CGainsWorks/emb-multirail-smps/docs/spec.md

# Specification

<!-- Generated by smps.report. Do not edit by hand; `make demo` overwrites this file. -->

Generated from `simulation/smps/spec.py`, which is the only place any of these
numbers are written down.

## System

| item | value |
|---|---|
| Input voltage | 8 V to 36 V DC, nominal 24 V |
| Survivable input excursion | 40 V, non operating, clamping is external |
| Ambient | 0 C to 55 C |
| Cooling | natural convection, no heatsink |
| Useful output power | 21.45 W at the connectors |
| Junction limit assumed | 125 C for every part |
| EMC reference envelope | EN 55032 Class B, conducted, 150 kHz to 30 MHz |

## Rails

| rail | topology | control | source | Vout [V] | Iout total [A] | at connector [A] | ripple [mVpp] | tol [%] | fsw [kHz] |
|---|---|---|---|---|---|---|---|---|---|
| +5V | buck | peak-current-mode | VIN | 5.0 | 5.0 | 1.5 | 25.0 | 1.0 | 500.0 |
| +3V3 | buck | voltage-mode | +5V | 3.3 | 3.0 | 2.5 | 20.0 | 1.0 | 1000.0 |
| +12V | boost | peak-current-mode | +5V | 12.0 | 0.4 | 0.4 | 50.0 | 2.0 | 400.0 |
| +1V8A | ldo | linear | +3V3 | 1.8 | 0.5 | 0.5 | 2.0 | 2.0 | - |

The current in "Iout total" includes downstream rails. The +5V stage feeds the
+3V3 buck and the +12V boost as well as its own connector load, and the +3V3
buck feeds the +1V8A LDO, so only the "at connector" column is available to a
user. `smps.losses.solve_power_tree` works this out rather than trusting a
hand written budget.

## Transient and loop targets

| rail | load step [A] | slew [A/us] | max deviation [mV] | settle within [us] | fc target [kHz] | PM target [deg] | GM target [dB] |
|---|---|---|---|---|---|---|---|
| +5V | 1.5 | 1.0 | 150.0 | 100.0 | 50.0 | 55.0 | 8.0 |
| +3V3 | 1.0 | 1.0 | 100.0 | 50.0 | 100.0 | 55.0 | 8.0 |
| +12V | 0.2 | 0.1 | 300.0 | 1000.0 | 6.0 | 50.0 | 8.0 |
| +1V8A | 0.25 | 1.0 | 50.0 | 20.0 | 120.0 | 45.0 | 10.0 |

The +1V8A rail has a crossover target listed for completeness but it is not a
design input: the LDO's loop is inside a bought in part. What this design
controls there is the output capacitor, the preload and the input decoupling,
so the requirement on that rail is phase margin and supply rejection, not
bandwidth.

## Out of scope

* Input transient suppression beyond the 40 V survivable level.
  Load dump clamping, if the end application needs it, is an external TVS.
* Reverse polarity beyond the series diode shown in the netlist.
* Isolation. Every rail shares one return.
* Common mode emissions. The pre-scan in this repository is differential mode
  only; see `docs/emc_prescan_method.md`.
* Any form of digital telemetry or sequencing control.

## Sequencing

The rails come up in power tree order because each one is fed by the one above
it. Nothing enforces a sequence beyond that, which is adequate for the loads
described and is called out here so that a user who needs a strict sequence
knows it is not provided.
