CGainsWorks/emb-multirail-smps/docs/compensation/buck3v3_voltage_mode.md

# +3V3 buck: voltage mode, Type III compensation

Target: crossover 100 kHz, phase margin at least 55 degrees, gain margin at
least 8 dB, from a regulated 5 V input.

This rail is deliberately compensated differently from the other two. It is fed
from the +5V rail rather than from VIN, so the one percent input band removes
the main argument for current mode, and at 1 MHz a current sense chain costs a
shunt, an amplifier and a leading edge blanking window that a sawtooth and a
comparator do not. What it costs instead is six passives rather than three, and
an LC double pole to get the phase back over.

---

## 1. The plant

```
L        = 1.5 uH             DCR     = 15 mOhm
Cout     = 33 uF              ESR     = 1.0 mOhm  (two 22 uF 16 V, derated 0.75)
Rds(on)  = 30 mOhm high side, 20 mOhm low side
fsw      = 1 MHz
Vin      = 5.0 V              Vramp   = 1.0 Vpp
```

A voltage mode buck's control to output response is the modulator gain times
the LC filter:

```
Gvd(s) = (Vin / Vramp) * (1 + s/w_esr) / (1 + s/(w0 Q) + (s/w0)^2)
```

with

```
Vin/Vramp = 5.0                                            (14.0 dB)
f0        = 1 / (2 pi sqrt(1.5e-6 * 33e-6))   = 22.6 kHz
Q         = R sqrt(C/L) = 1.1 * sqrt(22)      = 5.16       at full load
f_esr     = 1 / (2 pi * 1e-3 * 33e-6)         = 4.8 MHz    (irrelevant)
```

The numeric model, which includes the DCR and the switch resistances, puts the
magnitude peak at 22.2 kHz rather than 22.6 kHz, and damps it somewhat. That is
the whole difference between the closed form above and what
`statespace.buck_model` produces.

The problem to solve is the 180 degrees the double pole takes out inside about
one octave. At 100 kHz the plant has already given up essentially all of it,
so the compensator has to hand back roughly 50 degrees to reach a 55 degree
margin. One zero cannot do that. Two can.

---

## 2. The network

Type III around a voltage feedback error amplifier:

```
Zf = (Rf + 1/sCf1) || 1/sCf2            from COMP back to FB
Zi = R1 || (R3 + 1/sCf3)                from Vout to FB
Gc(s) = Zf / Zi
```

`R1` is the top divider resistor, so the divider is inside the network and does
not appear separately in the loop gain. The bottom resistor sits on a virtual
earth and does not appear in the small signal transfer at all, which is worth
knowing when reading the loop gain plot and wondering where it went.

Zeros, poles and the values that produce them:

```
fz1 = 1 / (2 pi Rf Cf1)
fz2 = 1 / (2 pi (R1 + R3) Cf3)
fp2 = 1 / (2 pi Rf (Cf1 Cf2 / (Cf1 + Cf2)))
fp3 = 1 / (2 pi R3 Cf3)
```

### Placement

* **Both zeros at half the LC resonance, 11.1 kHz.** Putting them together at
  `f0/2` gives close to the maximum phase boost at 100 kHz while keeping the
  loop gain shape simple. Splitting them, one below `f0` and one above, buys a
  slightly flatter magnitude and slightly less boost.
* **First pole at fsw/2, 500 kHz**, to attenuate switching ripple on the FB
  pin. With ceramic output capacitors the ESR zero is at 4.8 MHz, so there is
  nothing at a sensible frequency for this pole to cancel and its job is purely
  noise rejection.
* **Second pole at fsw, 1 MHz**, for the same reason.
* **Gain solved for** so that `|Gc(fc) Gvd(fc)| = 1` at exactly 100 kHz.

### Values

```
R1   = 10.2 kOhm      chosen, sets the divider current at about 0.25 mA
Rbot = R1 * 0.891 / (3.3 - 0.891) = 3.773 kOhm -> 3.74 kOhm (E96)
Vout = 0.891 * (10.2 + 3.74) / 3.74 = 3.3210 V   (+0.64 % from nominal)

R3   = R1 / (fp3/fz2 - 1) = 10.2k / 89 = 115 Ohm (E96)
Cf3  = 1 / (2 pi * 11.1e3 * (10.2k + 115)) = 1.39 nF -> 1.3 nF (E24)
Rf   = 4.42 kOhm (E96), solved for the crossover
Cf1  = 1 / (2 pi * 11.1e3 * 4.42e3) = 3.24 nF -> 3.3 nF (E24)
Cf2  = Cf1 / (2 pi fp2 Rf Cf1 - 1)  = 76 pF   -> 75 pF (E24)
```

With those snapped values the network actually sits at

```
fz1 = 10.91 kHz     fz2 = 11.87 kHz
fp2 = 491 kHz       fp3 = 1.065 MHz
```

The 0.891 V reference is the TPS54317's. Before a regulator was chosen this
rail assumed 0.8 V, which gave 3.24 kOhm and 4.53 kOhm. With an op amp error
amplifier the bottom resistor sits on a virtual earth, so changing it moves
the set point and nothing else; `Rf` moved because the amplifier itself
changed (below).

---

## 3. Predicted margins

Contributions at 100 kHz:

| term | phase at 100 kHz |
|---|---|
| compensator integrator | -90.0 deg |
| zero at 10.91 kHz | +83.8 deg |
| zero at 11.87 kHz | +83.2 deg |
| pole at 491 kHz | -11.5 deg |
| pole at 1.065 MHz | -5.4 deg |
| plant LC double pole, 22.2 kHz, Q ~ 5 | -177.4 deg |
| plant ESR zero, 4.8 MHz | +1.2 deg |
| **total** | **-116.1 deg** |

Phase margin 63.9 degrees by hand, with an ideal amplifier, against the
numeric model's **63.3 degrees at 100.2 kHz**. The switching simulation gives
**65.9 degrees at 99.1 kHz**.

Two corrections pull in opposite directions. The closed form treats the LC
pair as undamped apart from the load, so at 100 kHz it has already surrendered
177.4 of its 180 degrees; the numeric model carries the inductor DCR and both
switch resistances, which damp the resonance and give back about 2.8 degrees.
The numeric model also carries the error amplifier's finite gain bandwidth,
which the hand sum leaves out, and that costs 3.4 degrees. Net, the numeric
model sits 0.6 degrees below the hand sum, and it is the one the compensator is
designed against.

The amplifier figures are the TPS54317 data sheet's typical values, 110 dB of
open loop gain and 5 MHz unity gain bandwidth. An earlier assumption of 12 MHz
cost only 1.4 degrees. The switching simulator carries the same finite
amplifier as the hand model; when it carried an ideal one, the 5 MHz part
opened a 6 degree gap between the two that was the simulator's omission, not
the design's.

Gain margin from the model is 11.7 dB, with the -180 degree crossing at
326 kHz. The switching measurement sees that crossing too, at 12.8 dB, because
it now falls inside the 500 kHz Nyquist limit that sampling once per switching
cycle imposes. A bench analyser triggered off the switching clock has the same
limit for the same reason.

---

## 4. Across the operating range

| operating point | fc | PM | GM |
|---|---|---|---|
| 5.00 V, 3.0 A | 100.2 kHz | 63.3 deg | 11.7 dB |
| 4.95 V, 3.0 A | 99.3 kHz | 63.4 deg | 11.8 dB |
| 5.05 V, 3.0 A | 101.2 kHz | 63.2 deg | 11.6 dB |
| 5.00 V, 0.3 A | 100.9 kHz | 60.8 deg | 11.5 dB |

A one percent input band moves the crossover by one percent, which is what a
voltage mode modulator with gain `Vin/Vramp` should do and is the reason this
scheme is only acceptable on a rail with a regulated input. Put the same loop
on 8 to 36 V and the crossover would move by a factor of 4.5.

Light load raises the LC Q, which is why the phase margin is worst at 0.3 A
rather than at full load. It is still 5.8 degrees above target.

---

## 5. What would change this

1. **The power stage resistance.** The TPS54317's ramp, 1.0 Vpp, is now a
   data sheet figure and matches what this design assumed. Its FETs are not:
   59 mOhm typical at 6 V against the 30 and 20 mOhm modelled. More
   resistance damps the LC pair, which helps the margin a little and costs
   efficiency, and it is on `outputs/VERIFY.csv` to be re-run.
2. **Ceramic derating at 3.3 V.** The 0.75 retention factor sets the LC
   resonance. If the real parts hold 0.6, `f0` moves to 25 kHz and both
   compensator zeros are then placed too low.
3. **Discontinuous conduction below about 0.4 A.** Below that the inductor
   current touches zero, the plant becomes first order and this compensator is
   over compensated rather than under, which is the safe direction but is not
   modelled here.
