CGainsWorks/emb-multirail-smps/test-results/emc-prescan/spectrum.csv

f_hz | level_dbuv | limit_dbuv | margin_db | v_in_v
500000.0 | 51.28 | 56.0 | 4.72 | 8.0
1000000.0 | 20.46 | 56.0 | 35.54 | 8.0
1500000.0 | -23.24 | 56.0 | 79.24 | 8.0
2000000.0 | -15.28 | 56.0 | 71.28 | 8.0
2500000.0 | -12.65 | 56.0 | 68.65 | 8.0
3000000.0 | -10.25 | 56.0 | 66.25 | 8.0
3500000.0 | -3.62 | 56.0 | 59.62 | 8.0
4000000.0 | -13.44 | 56.0 | 69.44 | 8.0
4500000.0 | -6.15 | 56.0 | 62.15 | 8.0
5000000.0 | -4.41 | 60.0 | 64.41 | 8.0
5500000.0 | -31.35 | 60.0 | 91.35 | 8.0
6000000.0 | -5.56 | 60.0 | 65.56 | 8.0
6500000.0 | -7.05 | 60.0 | 67.05 | 8.0
7000000.0 | -18.27 | 60.0 | 78.27 | 8.0
7500000.0 | -6.06 | 60.0 | 66.06 | 8.0
8000000.0 | -10.87 | 60.0 | 70.87 | 8.0
8500000.0 | -13.08 | 60.0 | 73.08 | 8.0
9000000.0 | -7.2 | 60.0 | 67.2 | 8.0
9500000.0 | -16.64 | 60.0 | 76.64 | 8.0
10000000.0 | -11.07 | 60.0 | 71.07 | 8.0
10500000.0 | -8.91 | 60.0 | 68.91 | 8.0
11000000.0 | -29.97 | 60.0 | 89.97 | 8.0
11500000.0 | -10.35 | 60.0 | 70.35 | 8.0
12000000.0 | -11.26 | 60.0 | 71.26 | 8.0
12500000.0 | -24.45 | 60.0 | 84.45 | 8.0
13000000.0 | -10.43 | 60.0 | 70.43 | 8.0
13500000.0 | -14.54 | 60.0 | 74.54 | 8.0
14000000.0 | -17.86 | 60.0 | 77.86 | 8.0
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
