CGainsWorks/emb-multirail-smps/test-results/transient/load_step.csv

rail | step_a | undershoot_mv | overshoot_mv | limit_mv | settle_time_us | settle_limit_us
+5V | 1.5 | 98.72 | 2.53 | 150.0 | 28.4 | 100.0
+3V3 | 1.0 | 42.78 | 2.89 | 100.0 | 5.3 | 50.0
+12V | 0.2 | 197.82 | 12.21 | 300.0 | 241.5 | 1000.0
