CGainsWorks/emb-multirail-smps/test-results/transient/3v3_load_step.png

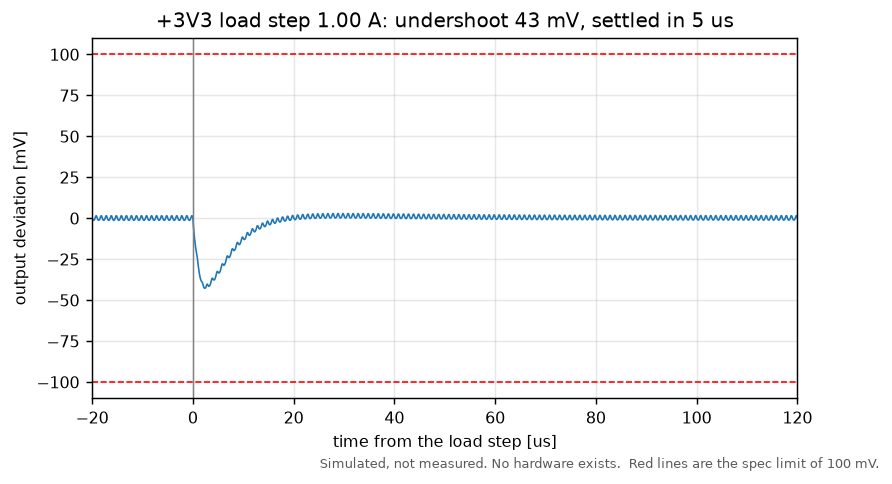
test-results/transient/3v3_load_step.png
