CGainsWorks/emb-multirail-smps/test-results/transient/12v_load_step.png

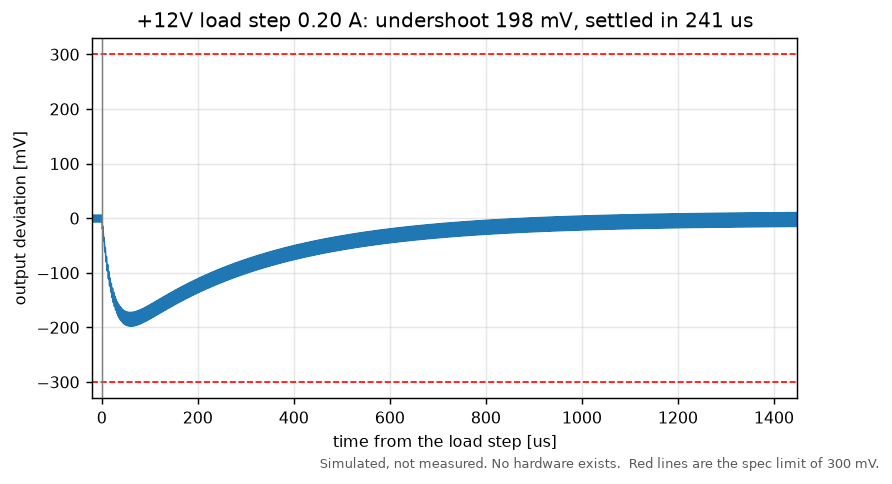
test-results/transient/12v_load_step.png
