CGainsWorks/emb-multirail-smps/docs/validation_report.md

# Validation report

<!-- Generated by smps.report. Do not edit by hand; `make demo` overwrites this file. -->

Every number in this file is produced by `make demo`. The date it was produced
is in the git history, which is a better record than a line in a generated
document that would otherwise change every day for no reason.

## What was validated, and what that word means here

Nothing in this report is a measurement. No board has been fabricated,
assembled, powered or probed. Every figure comes from a model running on a
desktop machine.

What has been checked is the thing the project brief puts first: that the loop
compensation derived by hand produces the crossover and phase margin claimed
for it, when the actual switching converter is simulated cycle by cycle with a
small signal injected into the feedback path and the loop gain extracted the
same way a Bode analyser extracts it.

Two independent routes to the same number:

1. **Hand derived.** Each power stage is written as two linear systems, one per
   switch state, averaged and linearised. For the current mode rails the
   comparator loop is closed with the Ridley sampled data model. The
   compensator is a closed form network response. `docs/compensation/` shows
   the derivation with this board's arithmetic written out.
2. **Simulated.** The same converter run as a switching circuit, with the
   compensator carried as extra states, the switching instant found by root
   finding on the real comparator condition, and the loop gain measured by
   injection.

They share the component values and nothing else. The power stage model in
route 2 does not use route 1's transfer functions.

## Result: the two routes agree

| rail | f_cross_target_hz | f_cross_hand_hz | f_cross_sim_hz | f_cross_error_pct | pm_target_deg | pm_hand_deg | pm_sim_deg | pm_error_deg | gm_hand_db | gm_sim_db | injection_linearity_rel |
|---|---|---|---|---|---|---|---|---|---|---|---|
| +5V | 50000.0 | 50544.3 | 50773.5 | 0.45 | 55.0 | 60.92 | 62.81 | 1.88 | 12.49 | no -180 deg crossing below fsw/2 | 1.22e-04 |
| +3V3 | 100000.0 | 100229.1 | 99052.6 | -1.17 | 55.0 | 63.3 | 65.89 | 2.59 | 11.7 | 12.82 | 1.62e-04 |
| +12V | 6000.0 | 5935.5 | 6262.7 | 5.51 | 50.0 | 76.6 | 78.32 | 1.72 | 14.3 | 15.5 | 1.39e-04 |

Worst crossover disagreement 5.5 percent, worst phase margin
disagreement 2.6 degrees. The gate the brief sets, that the
simulation has to match the hand calculation before boards are ordered, is met.

`injection_linearity_rel` is the fractional change in measured loop gain when
the injection amplitude is doubled. Values around 1e-4 mean the measurement is
in the small signal regime, which is the same check a careful bench sweep does.

Where the simulation is expected to differ from the hand model, and does:

* Above roughly a fifth of the switching frequency the averaged model loses
  accuracy because averaging assumes the ripple is small compared with the
  signal being measured. That is visible as the two traces separating at the
  top of each Bode plot.
* The boost disagrees slightly more than the bucks at low frequency. The
  Ridley model drops the input and output voltage feedforward terms in the
  duty cycle modulator, and for a boost those are not quite negligible.
* Neither route models dead time, reverse recovery, gate driver delay or
  layout inductance. All of those cost phase on real hardware, so a bench
  measurement should come in worse than this, not better.

## Sizing against the specification

| quantity | unit | required | chosen | direction | margin_pct | pass | note |
|---|---|---|---|---|---|---|---|
| L, +5V buck | H | 5.74074e-06 | 6.8e-06 | chosen >= required | 18.45 | True | 30% ripple at Vin(max) = 36 V |
| Inductor Isat headroom, +5V | A | 5.63317 | 9 | chosen >= required | 59.77 | True | peak = Iout + dI/2 = 5.633 A |
| Cout, +5V buck | F | 2.11057e-05 | 4.62e-05 | chosen >= required | 118.9 | True | capacitive share of the ripple budget |
| Output ripple, +5V | Vpp | 0.025 | 0.00769672 | chosen <= required | 69.21 | True | capacitive plus ESR, steady state |
| Load step deviation, +5V | V | 0.15 | 0.103347 | chosen <= required | 31.1 | True | dI/(2*pi*fc*Cout) at fc = 50 kHz |
| L, +3V3 buck | H | 1.24667e-06 | 1.5e-06 | chosen >= required | 20.32 | True | 30% ripple, fixed 5 V input |
| Inductor Isat headroom, +3V3 | A | 3.374 | 6 | chosen >= required | 77.83 | True | peak = 3.374 A |
| Cout, +3V3 buck | F | 7.79167e-06 | 3.3e-05 | chosen >= required | 323.53 | True |  |
| Output ripple, +3V3 | Vpp | 0.02 | 0.00358133 | chosen <= required | 82.09 | True |  |
| Load step deviation, +3V3 | V | 0.1 | 0.0482288 | chosen <= required | 51.77 | True |  |
| fc / f_LC ratio, +3V3 | - | 3 | 4.42061 | chosen >= required | 47.35 | True | f_LC = 22.62 kHz, needs enough separation for Type III |
| L, +12V boost | H | 2.17014e-05 | 2.2e-05 | chosen >= required | 1.38 | True | 35% of IL = 0.960 A, raised from 30 % to keep the RHP zero high |
| Inductor Isat headroom, +12V | A | 1.12572 | 2.5 | chosen >= required | 122.08 | True | peak = 1.126 A |
| Cout, +12V boost | F | 1.94444e-05 | 2.42e-05 | chosen >= required | 24.46 | True |  |
| Output ripple, +12V | Vpp | 0.05 | 0.0257933 | chosen <= required | 48.41 | True |  |
| f_RHPZ / fc ratio, +12V | - | 5 | 6.27979 | chosen >= required | 25.6 | True | f_RHPZ = 37.68 kHz at full load |
| Load step deviation, +12V | V | 0.3 | 0.219222 | chosen <= required | 26.93 | True |  |
| Dropout headroom, +1V8A | V | 0.25 | 1.2987 | chosen >= required | 419.48 | True | worst case 3V3 low, less 168 mV across the input filter resistor |
| LDO dissipation, +1V8A | W | 1 | 0.75 | chosen <= required | 25.0 | True | package limit assumption, confirm with the real thermal pad |

## Load regulation and ripple

| rail | v_in_v | i_out_a | v_out_v | deviation_from_light_load_pct | ripple_mvpp | ripple_limit_mvpp |
|---|---|---|---|---|---|---|
| +5V | 24.0 | 0.25 | 4.984357 | 0.0 | 6.32 | 25.0 |
| +5V | 24.0 | 1.25 | 4.984343 | -0.0 | 6.339 | 25.0 |
| +5V | 24.0 | 2.5 | 4.984333 | -0.0 | 6.363 | 25.0 |
| +5V | 24.0 | 3.75 | 4.984323 | -0.001 | 6.386 | 25.0 |
| +5V | 24.0 | 5.0 | 4.98432 | -0.001 | 6.41 | 25.0 |
| +3V3 | 5.0 | 0.15 | 3.321 | 0.0 | 2.863 | 20.0 |
| +3V3 | 5.0 | 0.75 | 3.321 | -0.0 | 2.838 | 20.0 |
| +3V3 | 5.0 | 1.5 | 3.321 | -0.0 | 2.806 | 20.0 |
| +3V3 | 5.0 | 2.25 | 3.321001 | 0.0 | 2.773 | 20.0 |
| +3V3 | 5.0 | 3.0 | 3.321 | 0.0 | 2.739 | 20.0 |
| +12V | 5.0 | 0.02 | 12.026313 | 0.0 | 2.474 | 50.0 |
| +12V | 5.0 | 0.1 | 12.026274 | -0.0 | 6.26 | 50.0 |
| +12V | 5.0 | 0.2 | 12.026225 | -0.001 | 12.649 | 50.0 |
| +12V | 5.0 | 0.3 | 12.026177 | -0.001 | 19.157 | 50.0 |
| +12V | 5.0 | 0.4 | 12.026195 | -0.001 | 25.704 | 50.0 |

## Line regulation

| rail | v_in_v | i_out_a | v_out_v | deviation_from_8v_pct | ripple_mvpp |
|---|---|---|---|---|---|
| +5V | 8.0 | 5.0 | 4.984322 | 0.0 | 2.949 |
| +5V | 12.0 | 5.0 | 4.98432 | -0.0 | 4.669 |
| +5V | 18.0 | 5.0 | 4.984316 | -0.0 | 5.828 |
| +5V | 24.0 | 5.0 | 4.98432 | -0.0 | 6.41 |
| +5V | 30.0 | 5.0 | 4.984312 | -0.0 | 6.759 |
| +5V | 36.0 | 5.0 | 4.98431 | -0.0 | 7.001 |
| +3V3 | 4.95 | 3.0 | 3.321 | 0.0 | 2.678 |
| +3V3 | 5.0 | 3.0 | 3.321 | 0.0 | 2.739 |
| +3V3 | 5.05 | 3.0 | 3.321 | 0.0 | 2.798 |
| +12V | 4.95 | 0.4 | 12.026124 | 0.0 | 25.895 |
| +12V | 5.0 | 0.4 | 12.026195 | 0.001 | 25.704 |
| +12V | 5.05 | 0.4 | 12.02613 | 0.0 | 25.513 |

The +5V stage is essentially indifferent to input voltage, which is not an
accident and is worth stating precisely because it looks too good. With peak
current mode and the artificial ramp set to the falling inductor current slope,
the modulator gain goes as 1/Vin while the control to output gain goes as Vin,
and the two cancel exactly in the averaged model. The real converter will not
be perfectly flat, because dead time, gate drive timing and Rds(on) all move
with operating point and none of them are in this model.

## Load transient

| rail | step_a | undershoot_mv | overshoot_mv | limit_mv | settle_time_us | settle_limit_us |
|---|---|---|---|---|---|---|
| +5V | 1.5 | 98.72 | 2.53 | 150.0 | 28.4 | 100.0 |
| +3V3 | 1.0 | 42.78 | 2.89 | 100.0 | 5.3 | 50.0 |
| +12V | 0.2 | 197.82 | 12.21 | 300.0 | 241.5 | 1000.0 |

## Efficiency

| v_in_v | load_fraction | p_in_w | i_in_a | p_useful_w | p_loss_w | efficiency_pct |
|---|---|---|---|---|---|---|
| 8.0 | 0.1 | 2.5217 | 0.3152 | 2.145 | 0.3767 | 85.063 |
| 8.0 | 0.25 | 5.9769 | 0.7471 | 5.3625 | 0.6144 | 89.72 |
| 8.0 | 0.5 | 11.8288 | 1.4786 | 10.725 | 1.1038 | 90.668 |
| 8.0 | 0.75 | 17.7991 | 2.2249 | 16.0875 | 1.7116 | 90.384 |
| 8.0 | 1.0 | 23.8899 | 2.9862 | 21.45 | 2.4399 | 89.787 |
| 24.0 | 0.1 | 2.6399 | 0.11 | 2.145 | 0.4949 | 81.253 |
| 24.0 | 0.25 | 6.16 | 0.2567 | 5.3625 | 0.7975 | 87.054 |
| 24.0 | 0.5 | 12.1206 | 0.505 | 10.725 | 1.3956 | 88.486 |
| 24.0 | 0.75 | 18.2004 | 0.7583 | 16.0875 | 2.1129 | 88.391 |
| 24.0 | 1.0 | 24.4017 | 1.0167 | 21.45 | 2.9517 | 87.904 |
| 36.0 | 0.1 | 2.7241 | 0.0757 | 2.145 | 0.5791 | 78.742 |
| 36.0 | 0.25 | 6.2928 | 0.1748 | 5.3625 | 0.9303 | 85.217 |
| 36.0 | 0.5 | 12.3349 | 0.3426 | 10.725 | 1.6099 | 86.948 |
| 36.0 | 0.75 | 18.497 | 0.5138 | 16.0875 | 2.4095 | 86.974 |
| 36.0 | 1.0 | 24.7811 | 0.6884 | 21.45 | 3.3311 | 86.558 |

Per stage numbers are in `test-results/efficiency/stage_efficiency.csv`. The
+1V8A rail sits near 1.8/3.3 by construction: it is a linear regulator and the
difference is heat, which is the price paid for a quiet analogue supply.

At high line the +5V stage is dominated by switching loss, not conduction loss.
If a bench measurement ever disagrees with this model, that is the term to
suspect first, because the overlap time it depends on is the hardest quantity
to predict from a datasheet.

## Thermal

Board to ambient resistance used: 7.44 K/W, from
100 by 80 mm of board, both faces,
natural convection plus radiation, derated to 60% for
the fraction actually coupled to the power stages.

| device | power_w | rth_jb_k_per_w | t_board_c | t_junction_c | margin_to_125c_k | v_in_v | t_ambient_c |
|---|---|---|---|---|---|---|---|
| U5 1V8 LDO | 0.6793 | 20.0 | 73.15 | 86.74 | 38.26 | 8.0 | 55.0 |
| U3 3V3 regulator | 0.4249 | 18.0 | 73.15 | 80.8 | 44.2 | 8.0 | 55.0 |
| L1 buck inductor | 0.2334 | 25.0 | 73.15 | 78.99 | 46.01 | 8.0 | 55.0 |
| Q1 buck HS FET | 0.4453 | 12.0 | 73.15 | 78.5 | 46.5 | 8.0 | 55.0 |
| Rs1 sense resistor | 0.1053 | 40.0 | 73.15 | 77.37 | 47.63 | 8.0 | 55.0 |
| L2 3V3 inductor | 0.1383 | 30.0 | 73.15 | 77.3 | 47.7 | 8.0 | 55.0 |
| Q3/Q4 boost FETs | 0.1011 | 35.0 | 73.15 | 76.69 | 48.31 | 8.0 | 55.0 |
| Q2 buck LS FET | 0.2461 | 12.0 | 73.15 | 76.11 | 48.89 | 8.0 | 55.0 |
| L3 boost inductor | 0.045 | 30.0 | 73.15 | 74.5 | 50.5 | 8.0 | 55.0 |
| U5 1V8 LDO | 0.6793 | 20.0 | 76.96 | 90.55 | 34.45 | 24.0 | 55.0 |
| Q1 buck HS FET | 0.8515 | 12.0 | 76.96 | 87.18 | 37.82 | 24.0 | 55.0 |
| U3 3V3 regulator | 0.4249 | 18.0 | 76.96 | 84.61 | 40.39 | 24.0 | 55.0 |
| L1 buck inductor | 0.2415 | 25.0 | 76.96 | 83.0 | 42.0 | 24.0 | 55.0 |
| Rs1 sense resistor | 0.1053 | 40.0 | 76.96 | 81.18 | 43.82 | 24.0 | 55.0 |
| L2 3V3 inductor | 0.1383 | 30.0 | 76.96 | 81.11 | 43.89 | 24.0 | 55.0 |
| Q2 buck LS FET | 0.3455 | 12.0 | 76.96 | 81.11 | 43.89 | 24.0 | 55.0 |
| Q3/Q4 boost FETs | 0.1011 | 35.0 | 76.96 | 80.5 | 44.5 | 24.0 | 55.0 |
| L3 boost inductor | 0.045 | 30.0 | 76.96 | 78.31 | 46.69 | 24.0 | 55.0 |
| Q1 buck HS FET | 1.2135 | 12.0 | 79.79 | 94.35 | 30.65 | 36.0 | 55.0 |
| U5 1V8 LDO | 0.6793 | 20.0 | 79.79 | 93.37 | 31.63 | 36.0 | 55.0 |
| U3 3V3 regulator | 0.4249 | 18.0 | 79.79 | 87.43 | 37.57 | 36.0 | 55.0 |
| L1 buck inductor | 0.2437 | 25.0 | 79.79 | 85.88 | 39.12 | 36.0 | 55.0 |
| Q2 buck LS FET | 0.3622 | 12.0 | 79.79 | 84.13 | 40.87 | 36.0 | 55.0 |
| Rs1 sense resistor | 0.1053 | 40.0 | 79.79 | 84.0 | 41.0 | 36.0 | 55.0 |
| L2 3V3 inductor | 0.1383 | 30.0 | 79.79 | 83.94 | 41.06 | 36.0 | 55.0 |
| Q3/Q4 boost FETs | 0.1011 | 35.0 | 79.79 | 83.32 | 41.68 | 36.0 | 55.0 |
| L3 boost inductor | 0.045 | 30.0 | 79.79 | 81.13 | 43.87 | 36.0 | 55.0 |

Maximum ambient at full load across the input range:
85.7 C against a specification of
55 C.

This is the crudest model here. It treats the board as isothermal, which it
will not be. Expect the real hot spot under the high side FET to be worse than
this says and the parts far from it to be better.

## Conducted emissions pre-scan

| v_in_v | worst_margin_db | worst_frequency_hz | filter_z_out_peak_ohm | filter_z_out_peak_hz | converter_z_in_ohm | middlebrook_separation_db |
|---|---|---|---|---|---|---|
| 8.0 | 4.72 | 500000.0 | 0.5006 | 3147.7 | 2.679 | 14.57 |
| 24.0 | 8.05 | 500000.0 | 0.5006 | 3147.7 | 23.605 | 33.47 |
| 36.0 | 11.2 | 500000.0 | 0.5006 | 3147.7 | 52.298 | 40.38 |

Differential mode only, modelled through a 10 uH input
inductor into a 2.2 uF film capacitor and a 50 ohm / 5 uH LISN.
The worst case is the fundamental at the switching frequency at low line, with
4.7 dB of margin at
Vin 8 V. That is thin for a prediction with this
much uncertainty in it, and it is the first thing a real pre-scan should look
at.

The input filter is also checked against Middlebrook's criterion, because a
converter running closed loop is a constant power load and looks like a
negative resistance below its loop bandwidth. Worst separation between the
filter output impedance and the converter input impedance is
14.6 dB. This is why the bulk
capacitor is an aluminium polymer part with deliberate ESR: swapping it for
more ceramic would improve the ripple and destabilise the input.

## Netlist

| parts | nets | pin_connections | single_pin_nets | duplicate_pin_connections | parts_with_no_net |
|---|---|---|---|---|---|
| 79 | 52 | 233 | 0 | 0 | 0 |

`outputs/netlists/board.net` is a Protel format netlist, which Altium imports
directly. It is a connection list, not a layout.

## How reproducible is any of this

Every result here is regenerated by `make demo` and compared against what is
committed, by `scripts/check_outputs_current.py`, on every push.

That comparison is numerical rather than byte for byte, and deliberately so.
The switching simulator finds each switching instant by secant iteration on the
real comparator condition, and where that iteration stops depends on the last
bits of a double precision subtraction. The closed loop then integrates the
resulting duty ratio differences over thousands of cycles. Measured across
Windows with numpy 1.26 and Linux with numpy 2.5, the settled output voltages
agree to about **one part per million**.

That is three orders of magnitude finer than any claim this report makes, and
roughly four orders finer than the uncertainty in the component values the
numbers are computed from, so it does not affect a single conclusion. It is
worth stating because it is the honest resolution of the simulator, and because
a reader comparing two runs digit by digit should know where to stop.

The one place it does matter is the load regulation table. The deviations there
are around 0.001 percent, which is only about ten times the solver's own
resolution. Read that column as "below what this model can resolve", not as a
measurement of 0.001 percent.

## What would change these numbers

In rough order of how much:

1. Real Rds(on), Qg, Qoss and switching times, at temperature, for real parts.
2. Real inductor core loss coefficients and DCR at temperature.
3. Layout: loop inductance in the input mesh, copper spreading for thermal,
   and the common mode path for EMC. None of it exists yet.
4. The controller's actual internal slope compensation, blanking and minimum
   on time, which this repository models generically rather than from any one
   datasheet.
