CGainsWorks/emb-multirail-smps/test-results/thermal/ambient_derating.csv

v_in_v | load_fraction | max_ambient_c
8.0 | 0.1 | 120.42
8.0 | 0.2 | 117.83
8.0 | 0.3 | 115.14
8.0 | 0.4 | 112.34
8.0 | 0.5 | 109.43
8.0 | 0.6 | 106.42
8.0 | 0.7 | 103.29
8.0 | 0.8 | 100.06
8.0 | 0.9 | 96.72
8.0 | 1.0 | 93.26
24.0 | 0.1 | 118.8
24.0 | 0.2 | 116.54
24.0 | 0.3 | 113.61
24.0 | 0.4 | 110.49
24.0 | 0.5 | 107.26
24.0 | 0.6 | 103.92
24.0 | 0.7 | 100.47
24.0 | 0.8 | 96.91
24.0 | 0.9 | 93.24
24.0 | 1.0 | 89.45
36.0 | 0.1 | 117.2
36.0 | 0.2 | 114.31
36.0 | 0.3 | 111.27
36.0 | 0.4 | 108.08
36.0 | 0.5 | 104.74
36.0 | 0.6 | 101.24
36.0 | 0.7 | 97.58
36.0 | 0.8 | 93.76
36.0 | 0.9 | 89.79
36.0 | 1.0 | 85.65
