CGainsWorks/emb-multirail-smps/test-results/bode/sweep_12v.csv

f_hz | gain_db | phase_deg
200.0 | 29.6141 | -93.6048
261.31 | 27.3072 | -92.899
341.406 | 25.0011 | -92.4204
446.055 | 22.6967 | -92.1446
582.772 | 20.394 | -92.0588
761.542 | 18.0906 | -92.157
995.025 | 15.7888 | -92.4375
1299.756 | 13.4901 | -92.9057
1698.514 | 11.1894 | -93.58
2219.14 | 8.8933 | -94.4924
2898.551 | 6.603 | -95.6941
3786.982 | 4.3126 | -97.26
4945.904 | 2.025 | -99.3003
6464.646 | -0.2723 | -102.0024
8443.272 | -2.5633 | -105.6085
11034.483 | -4.8457 | -110.4723
14414.414 | -7.078 | -116.9493
18823.529 | -9.2086 | -125.3849
24615.385 | -11.1796 | -136.0841
32323.232 | -12.93 | -149.2382
42105.263 | -14.3457 | -163.9453
55172.414 | -15.5393 | 179.4261
71111.111 | -16.5322 | 162.4434
94117.647 | -17.6407 | 141.6161
125000.0 | -18.7484 | 116.5349
162500.0 | -19.7383 | 89.0571
