CGainsWorks/emb-multirail-smps/test-results/bode/sweep_3v3.csv

f_hz | gain_db | phase_deg
2000.0 | 21.3143 | -72.5704
2438.281 | 19.7716 | -68.7038
2971.768 | 18.3043 | -64.1273
3623.188 | 16.9379 | -58.7449
4417.449 | 15.7162 | -52.5181
5383.58 | 14.6967 | -45.488
6562.756 | 13.9479 | -37.771
8000.0 | 13.5626 | -29.6908
9756.098 | 13.6557 | -21.8028
11887.073 | 14.3728 | -15.1587
14492.754 | 15.9288 | -11.6618
17660.044 | 18.5779 | -16.2551
21505.376 | 21.5655 | -42.6328
26229.508 | 19.6473 | -85.8322
32000.0 | 14.9805 | -104.3572
39024.39 | 11.1779 | -109.6496
47619.048 | 8.1545 | -111.0537
57971.014 | 5.6488 | -111.4058
70796.46 | 3.4002 | -111.78
86021.505 | 1.3837 | -112.7064
105263.158 | -0.5965 | -114.7158
126984.127 | -2.3777 | -118.0157
156862.745 | -4.3542 | -124.1708
190476.19 | -6.1899 | -133.1527
228571.429 | -8.0185 | -145.5349
281250.0 | -10.5099 | -164.7498
343750.0 | -14.1705 | 171.0547
406250.0 | -18.779 | 143.308
