CGainsWorks/emb-multirail-smps/test-results/bode/sweep_5v.csv

f_hz | gain_db | phase_deg
1000.0 | 35.2721 | -91.8317
1219.141 | 33.5262 | -92.2741
1485.884 | 31.7734 | -92.7626
1811.594 | 30.0059 | -93.2929
2208.724 | 28.2248 | -93.8499
2691.79 | 26.4337 | -94.4106
3281.378 | 24.6282 | -94.9522
4000.0 | 22.8157 | -95.4561
4878.049 | 20.9989 | -95.9234
5943.536 | 19.1967 | -96.3761
7246.377 | 17.4008 | -96.8653
8830.022 | 15.6244 | -97.4494
10752.688 | 13.8683 | -98.1919
13114.754 | 12.1106 | -99.166
16000.0 | 10.3596 | -100.4296
19512.195 | 8.6167 | -102.0385
23809.524 | 6.8675 | -104.0652
28985.507 | 5.13 | -106.5449
35398.23 | 3.344 | -109.6379
43010.753 | 1.5664 | -113.324
52631.579 | -0.3393 | -118.031
63492.063 | -2.192 | -123.4853
78431.373 | -4.3797 | -131.3017
95238.095 | -6.4498 | -140.2457
114285.714 | -8.4236 | -149.8171
140625.0 | -10.7385 | -161.2987
171875.0 | -13.1566 | -171.9795
203125.0 | -15.1835 | -179.6957
