CGainsWorks/emb-multirail-smps/test-results/efficiency/curve_12v.csv

i_out_a | efficiency_pct
0.008 | 80.5722
0.00884 | 82.0282
0.00978 | 83.3907
0.01081 | 84.6623
0.01195 | 85.8457
0.01321 | 86.9444
0.0146 | 87.9618
0.01614 | 88.902
0.01785 | 89.7689
0.01973 | 90.5666
0.02181 | 91.2991
0.02411 | 91.9705
0.02666 | 92.5848
0.02947 | 93.1457
0.03258 | 93.6569
0.03602 | 94.1219
0.03982 | 94.5439
0.04402 | 94.926
0.04867 | 95.2711
0.0538 | 95.5819
0.05948 | 95.8608
0.06575 | 96.11
0.07269 | 96.3317
0.08036 | 96.5276
0.08884 | 96.6994
0.09821 | 96.8486
0.10858 | 96.9765
0.12003 | 97.084
0.1327 | 97.1723
0.1467 | 97.242
0.16218 | 97.2937
0.17929 | 97.3278
0.19821 | 97.3446
0.21912 | 97.3441
0.24224 | 97.3263
0.2678 | 97.2908
0.29605 | 97.2373
0.32729 | 97.165
0.36182 | 97.0732
0.4 | 96.9606
