CGainsWorks/emb-multirail-smps/test-results/bode/1v8a_ldo_loop_gain.png

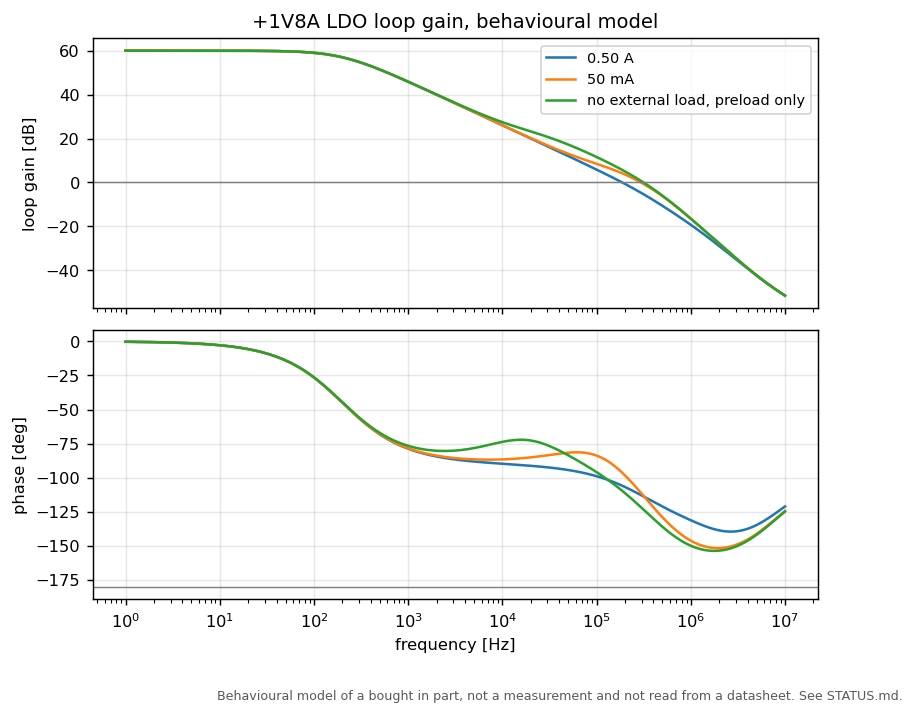
test-results/bode/1v8a_ldo_loop_gain.png
