CGainsWorks/emb-multirail-smps/test-results/bode/1v8a_ldo_psrr.png

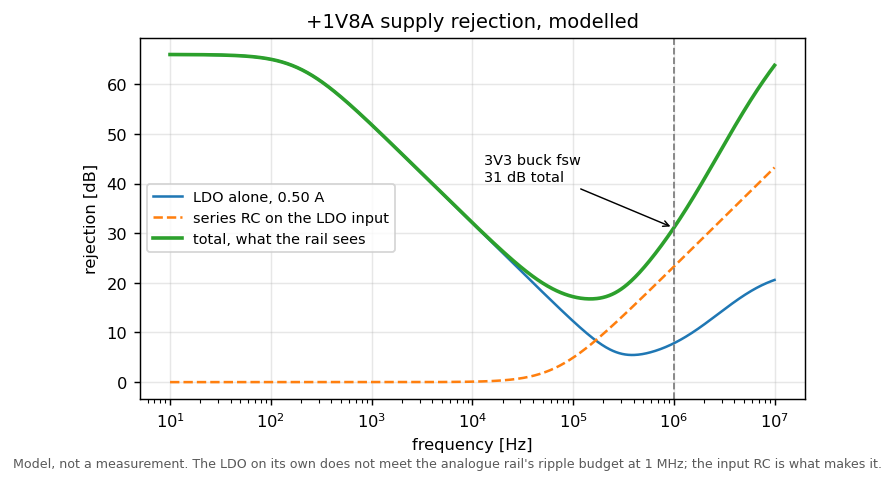
test-results/bode/1v8a_ldo_psrr.png
