CGainsWorks/emb-multirail-smps/test-results/bode/3v3_loop_gain.png

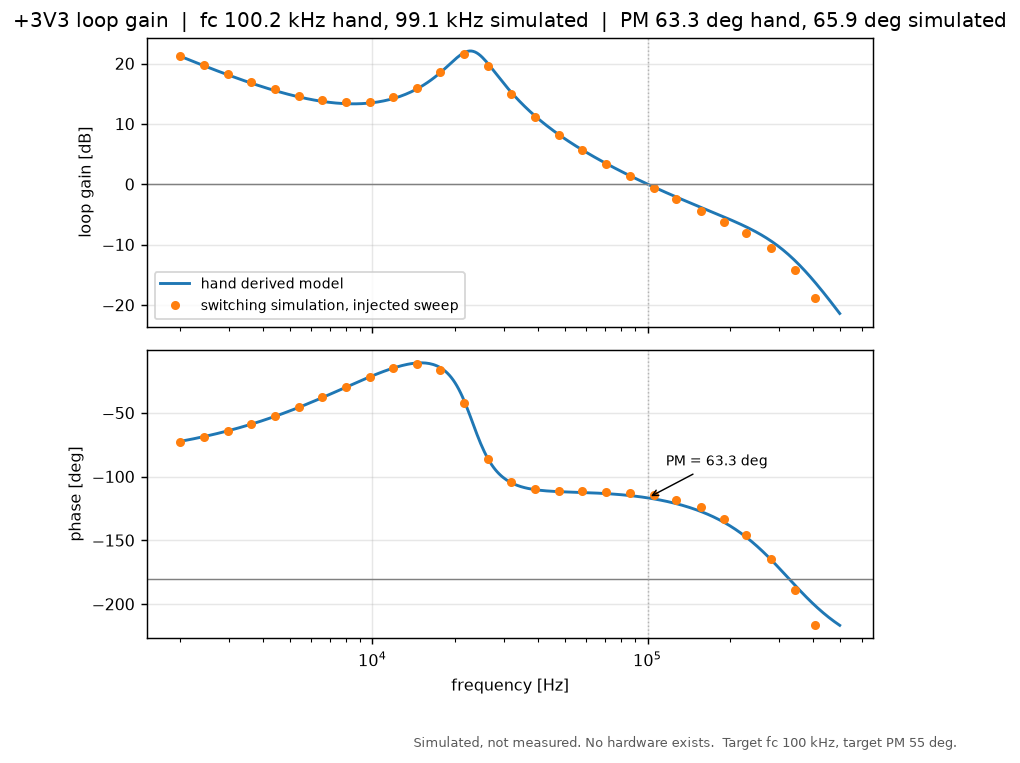
test-results/bode/3v3_loop_gain.png
