CGainsWorks/emb-multirail-smps/test-results/bode/12v_loop_gain.png

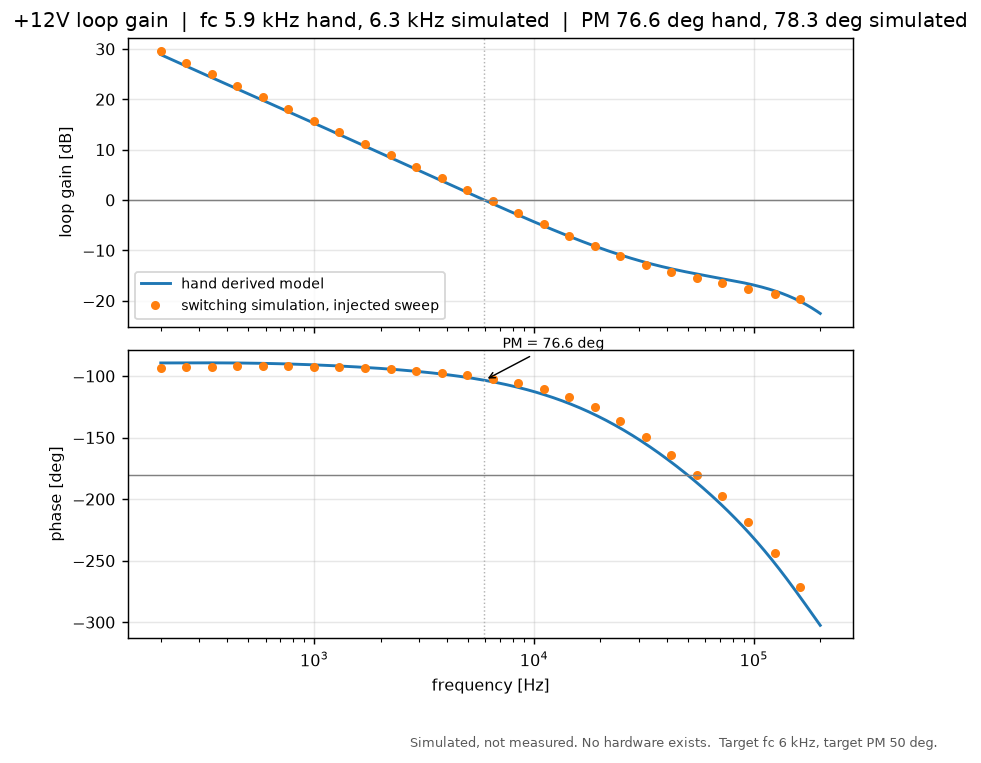
test-results/bode/12v_loop_gain.png
