CGainsWorks/emb-multirail-smps/test-results/efficiency/stage_efficiency.png

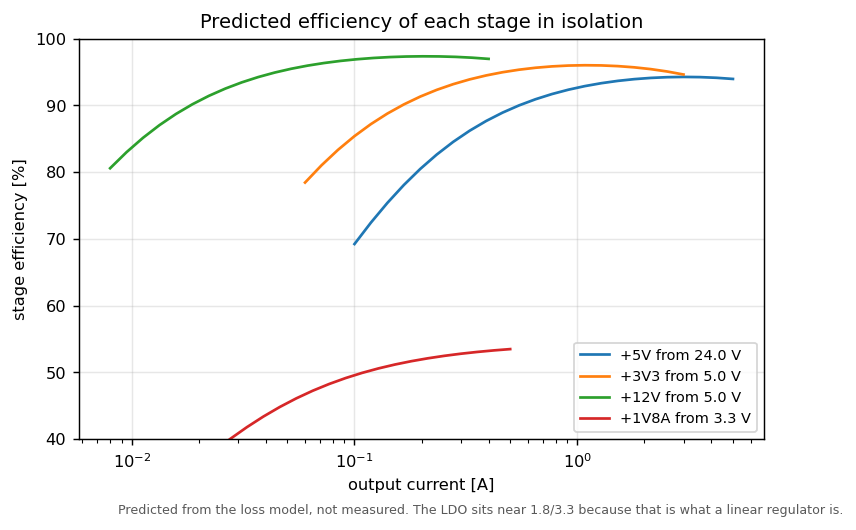
test-results/efficiency/stage_efficiency.png
