CGainsWorks/emb-multirail-smps/test-results/emc-prescan/input_filter_middlebrook.png

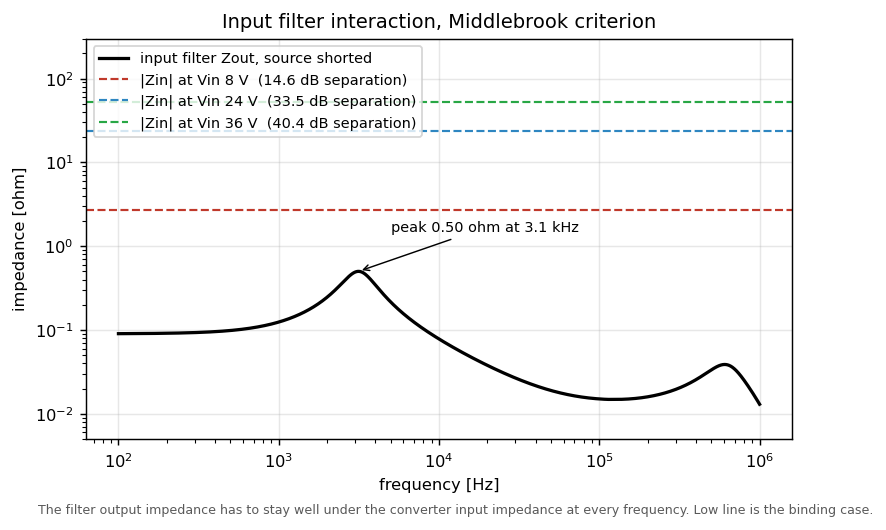
test-results/emc-prescan/input_filter_middlebrook.png
