CGainsWorks/emb-multirail-smps/test-results/line-regulation/line_regulation_5v.png

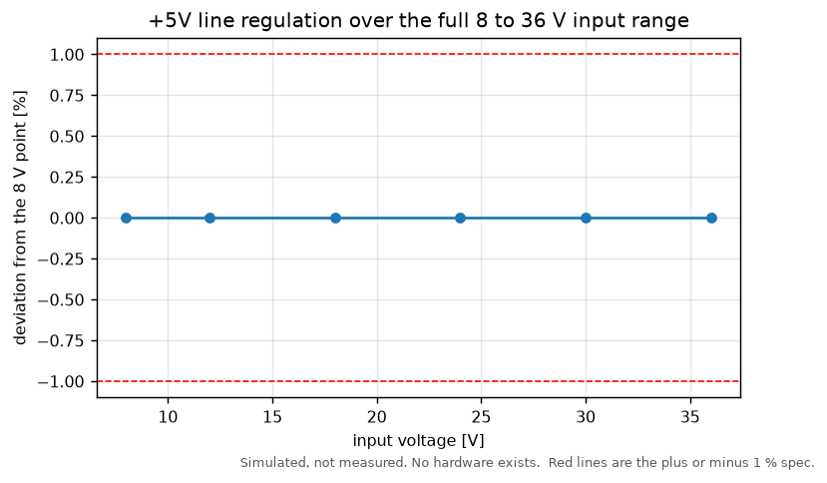
test-results/line-regulation/line_regulation_5v.png
