CGainsWorks/emb-multirail-smps/test-results/load-regulation/load_regulation.png

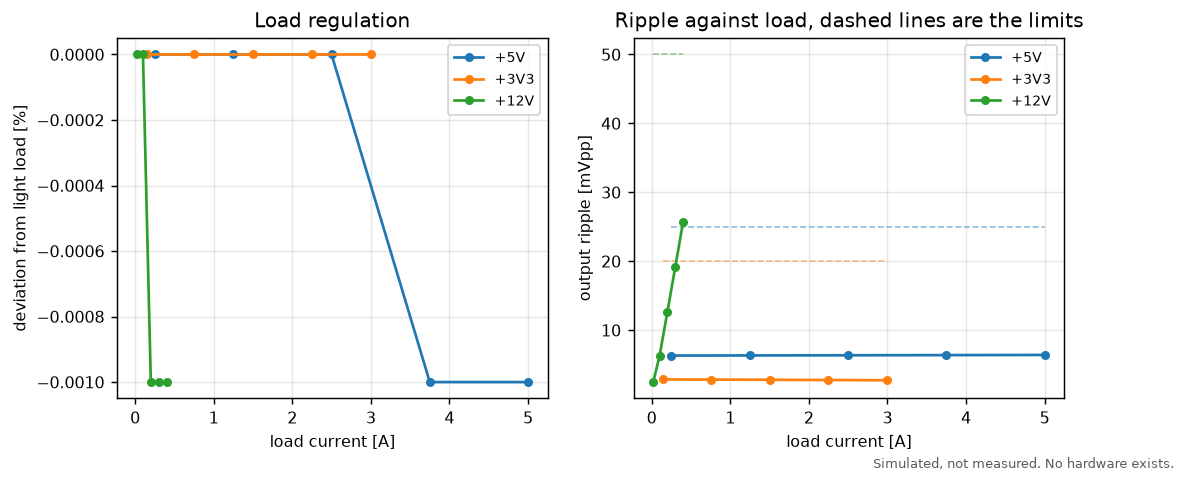
test-results/load-regulation/load_regulation.png
