CGainsWorks/emb-multirail-smps/test-results/thermal/ambient_derating.png

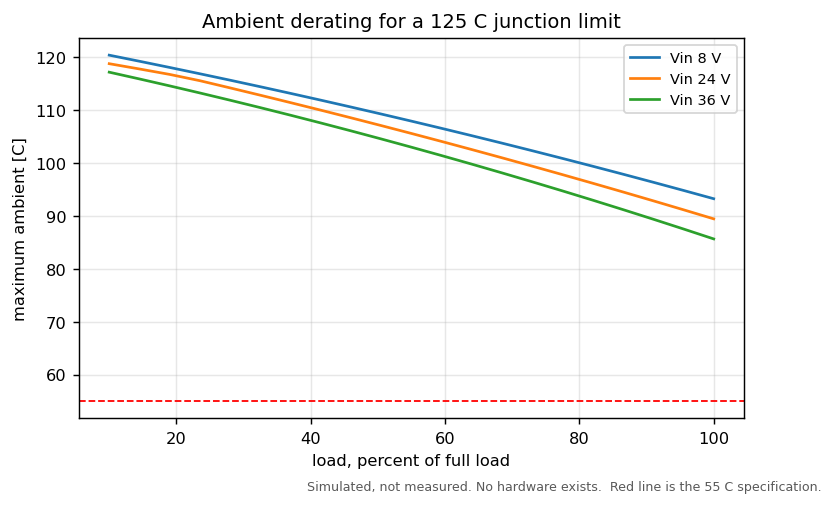
test-results/thermal/ambient_derating.png
