CGainsWorks/emb-multirail-smps/outputs/netlists/ltspice/comp_boost12_typeii_ac.cir

* LTspice dialect. Open in LTspice, or run: LTspice -b <file>
* Generated by smps.spice. Do not edit; `make demo` overwrites it.
* NOT EXECUTED BY CI. No runner has an LTspice. See STATUS.md.
* Type II compensation network, +12V rail
Vac   out 0 dc 0 ac 1
Rtop  out fb  44200
Rbot  fb  0   4990
Gea   0 comp  fb 0 0.0011
Ro    comp 0  1e+07
Rc    comp nc 3000
Cc    nc   0  1e-07
Cp    comp 0  2.7e-10
.ac dec 25 1 10meg
.end
