CGainsWorks/emb-multirail-smps/outputs/netlists/ltspice/comp_buck5_typeii_ac.cir

* LTspice dialect. Open in LTspice, or run: LTspice -b <file>
* Generated by smps.spice. Do not edit; `make demo` overwrites it.
* NOT EXECUTED BY CI. No runner has an LTspice. See STATUS.md.
* Type II compensation network, +5V rail
Vac   out 0 dc 0 ac 1
Rtop  out fb  26100
Rbot  fb  0   4990
Gea   0 comp  fb 0 0.002
Ro    comp 0  2e+07
Rc    comp nc 2400
Cc    nc   0  1.5e-08
Cp    comp 0  2.7e-10
.ac dec 25 1 10meg
.end
