CGainsWorks/emb-multirail-smps/hardware/kicad/emb-multirail-smps.kicad_pcb

## KiCad design hardware/kicad/emb-multirail-smps.kicad_pcb (2026-10-16)

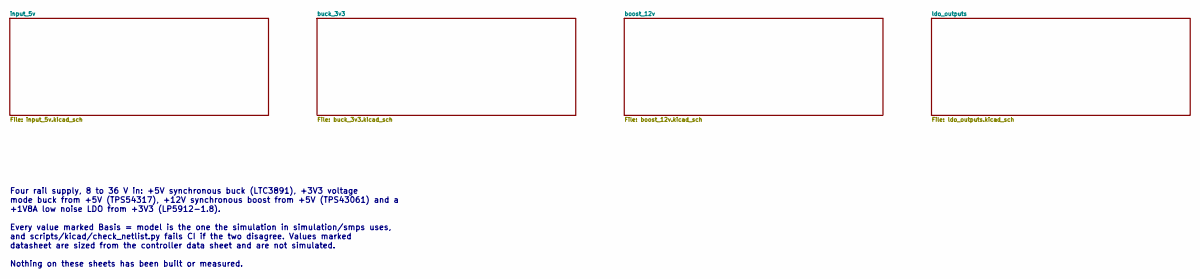
[picture p19: schematic emb-multirail-smps.kicad_sch, Multi-rail switch-mode power supply]

Notes on the sheet:
Four rail supply, 8 to 36 V in: +5V synchronous buck (LTC3891), +3V3 voltage mode buck from +5V (TPS54317), +12V synchronous boost from +5V (TPS43061) and a +1V8A low noise LDO from +3V3 (LP5912-1.8). Every value marked Basis = model is the one the simulation in simulation/smps uses, and scripts/ki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

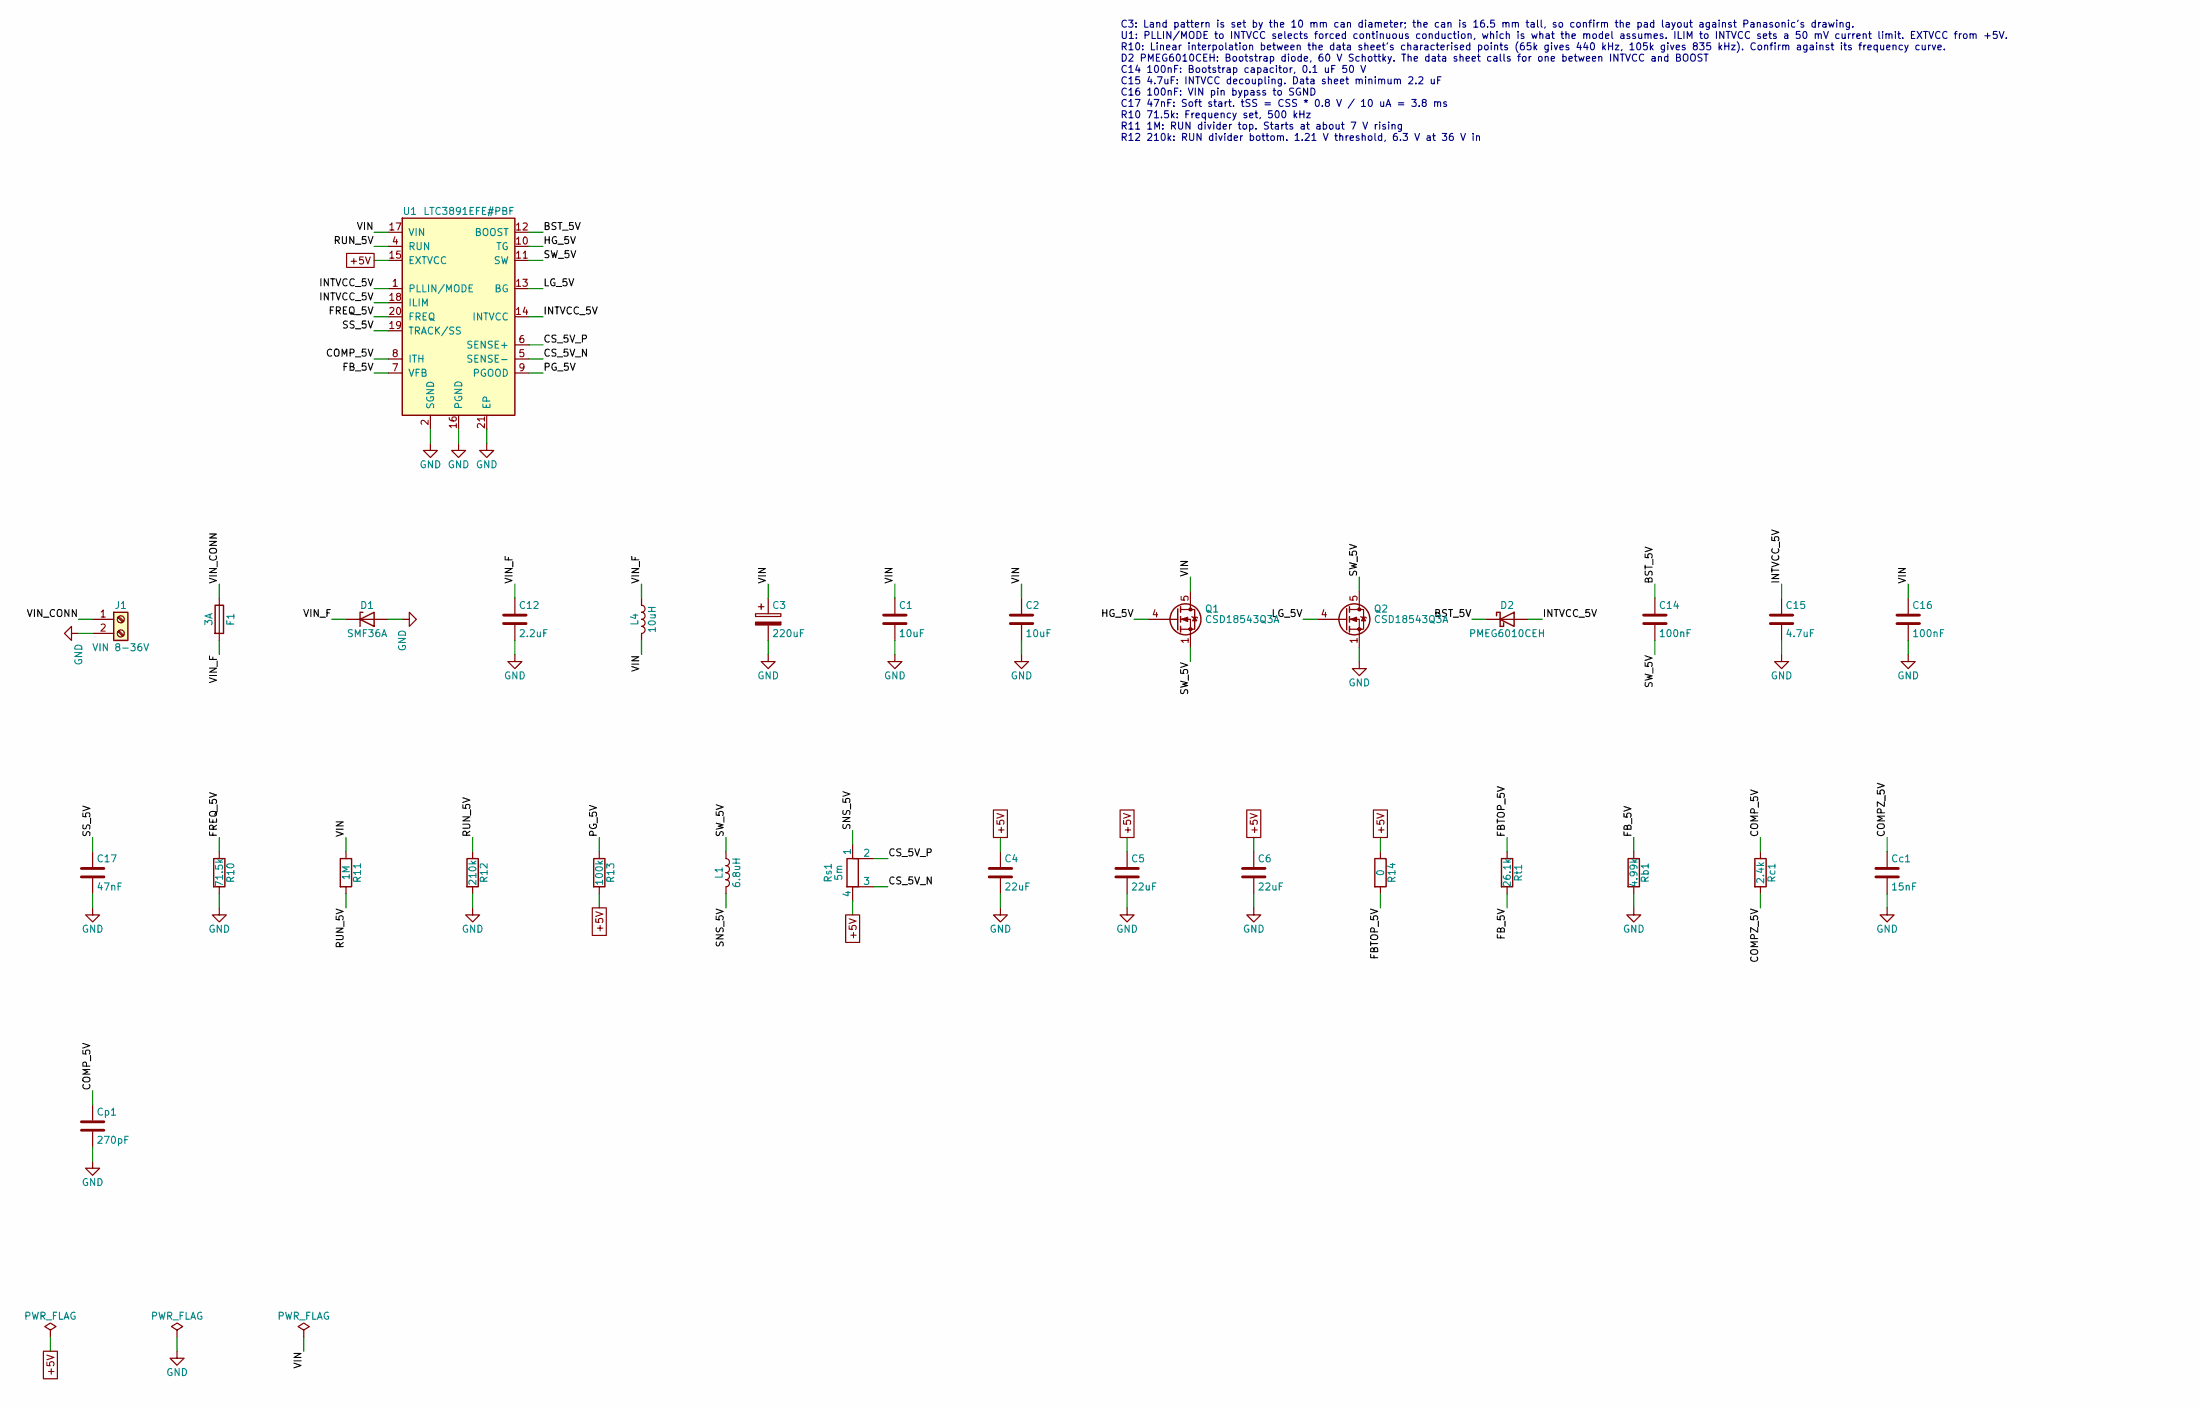
[picture p20: schematic input_5v.kicad_sch, Input protection, input filter and +5V buck]

Parts:
C1, C2: 10uF; C_1210_3225Metric; MPN GRM32ER71H106KA12L
C3: 220uF; CP_Elec_10x10.5; MPN EEH-ZS1H221P
C4, C5, C6: 22uF; C_1210_3225Metric; MPN GRM32ER71E226KE15L
C12: 2.2uF; C_1210_3225Metric; MPN GRM32ER72A225KA35L
C14: 100nF; C_0603_1608Metric; MPN GRM188R71H104KA93D
C15: 4.7uF; C_0805_2012Metric; MPN GRM21BR71C475KA73L
C16: 100nF; C_0402_1005Metric; MPN GRM155R71H104KE14D
C17: 47nF; C_0402_1005Metric; MPN GRM155R71C473KA01D
Cc1: 15nF; C_0402_1005Metric; MPN GRM155R71H153KA12D
Cp1: 270pF; C_0402_1005Metric; MPN C0402C271J5GACTU
D1: SMF36A; D_SOD-123F; MPN SMF36A
D2: PMEG6010CEH; D_SOD-123F; MPN PMEG6010CEH
F1: 3A; Fuse_1206_3216Metric; MPN CC12H3A-TR
J1: VIN 8-36V; TerminalBlock_Phoenix_MKDS-3-2-5.08_1x02_P5.08mm_Horizontal; MPN 1711725
L1: 6.8uH; L_Coilcraft_XAL8080-XXX; MPN XAL8080-682MED
L4: 10uH; L_Coilcraft_XAL7050-XXX; MPN XAL7050-103MEC
Q1, Q2: CSD18543Q3A; VSON-8_3.3x3.3mm_P0.65mm_NexFET; MPN CSD18543Q3A
R10: 71.5k; R_0402_1005Metric; MPN RC0402FR-0771K5L
R11: 1M; R_0603_1608Metric; MPN RC0603FR-071ML
R12: 210k; R_0402_1005Metric; MPN RC0402FR-07210KL
R13: 100k; R_0402_1005Metric; MPN RC0402FR-07100KL
R14: 0; R_0603_1608Metric; MPN RC0603JR-070RL
Rb1: 4.99k; R_0402_1005Metric; MPN RC0402FR-074K99L
Rc1: 2.4k; R_0402_1005Metric; MPN RC0402FR-072K4L
Rs1: 5m; R_Shunt_Vishay_WSK2512_6332Metric_T1.19mm; MPN WSK25125L000FEA
Rt1: 26.1k; R_0402_1005Metric; MPN RC0402FR-0726K1L
U1: LTC3891EFE#PBF; HTSSOP-20-1EP_4.4x6.5mm_P0.65mm_EP2.74x3.86mm; MPN LTC3891EFE#PBF

Connections:
+5V: C4.1, C5.1, C6.1, R13.2, R14.1, Rs1.4, U1.15 (EXTVCC); also elsewhere on the board
/input_5v/BST_5V: C14.1, D2.1 (K), U1.12 (BOOST)
/input_5v/COMPZ_5V: Cc1.1, Rc1.2
/input_5v/COMP_5V: Cp1.1, Rc1.1, U1.8 (ITH)
/input_5v/CS_5V_N: Rs1.3, U1.5 (SENSE-)
/input_5v/CS_5V_P: Rs1.2, U1.6 (SENSE+)
/input_5v/FBTOP_5V: R14.2, Rt1.1
/input_5v/FB_5V: Rb1.1, Rt1.2, U1.7 (VFB)
/input_5v/FREQ_5V: R10.1, U1.20 (FREQ)
/input_5v/HG_5V: Q1.4 (G), U1.10 (TG)
/input_5v/INTVCC_5V: C15.1, D2.2 (A), U1.1 (PLLIN/MODE), U1.14 (INTVCC), U1.18 (ILIM)
/input_5v/LG_5V: Q2.4 (G), U1.13 (BG)
/input_5v/PG_5V: R13.1, U1.9 (PGOOD)
/input_5v/RUN_5V: R11.2, R12.1, U1.4 (RUN)
/input_5v/SNS_5V: L1.2, Rs1.1
/input_5v/SS_5V: C17.1, U1.19 (TRACK/SS)
/input_5v/SW_5V: C14.2, L1.1, Q1.1 (S), Q1.2 (S), Q1.3 (S), Q2.5 (D), U1.11 (SW)
/input_5v/VIN: C1.1, C2.1, C3.1, C16.1, L4.2, Q1.5 (D), R11.1, U1.17 (VIN)
/input_5v/VIN_CONN: F1.1, J1.1
/input_5v/VIN_F: C12.1, D1.1 (K), F1.2, L4.1
GND: C1.2, C2.2, C3.2, C4.2, C5.2, C6.2, C12.2, C15.2, C16.2, C17.2, Cc1.2, Cp1.2, D1.2 (A), J1.2, Q2.1 (S), Q2.2 (S), Q2.3 (S), R10.2, R12.2, Rb1.2, U1.2 (SGND), U1.3 (SGND), U1.16 (PGND), U1.21 (EP); also elsewhere on the board

Notes on the sheet:
C3: Land pattern is set by the 10 mm can diameter; the can is 16.5 mm tall, so confirm the pad layout against Panasonic's drawing. U1: PLLIN/MODE to INTVCC selects forced continuous conduction, which is what the model assumes. ILIM to INTVCC sets a 50 mV current limit. EXTVCC from +5V. R10: Linear 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

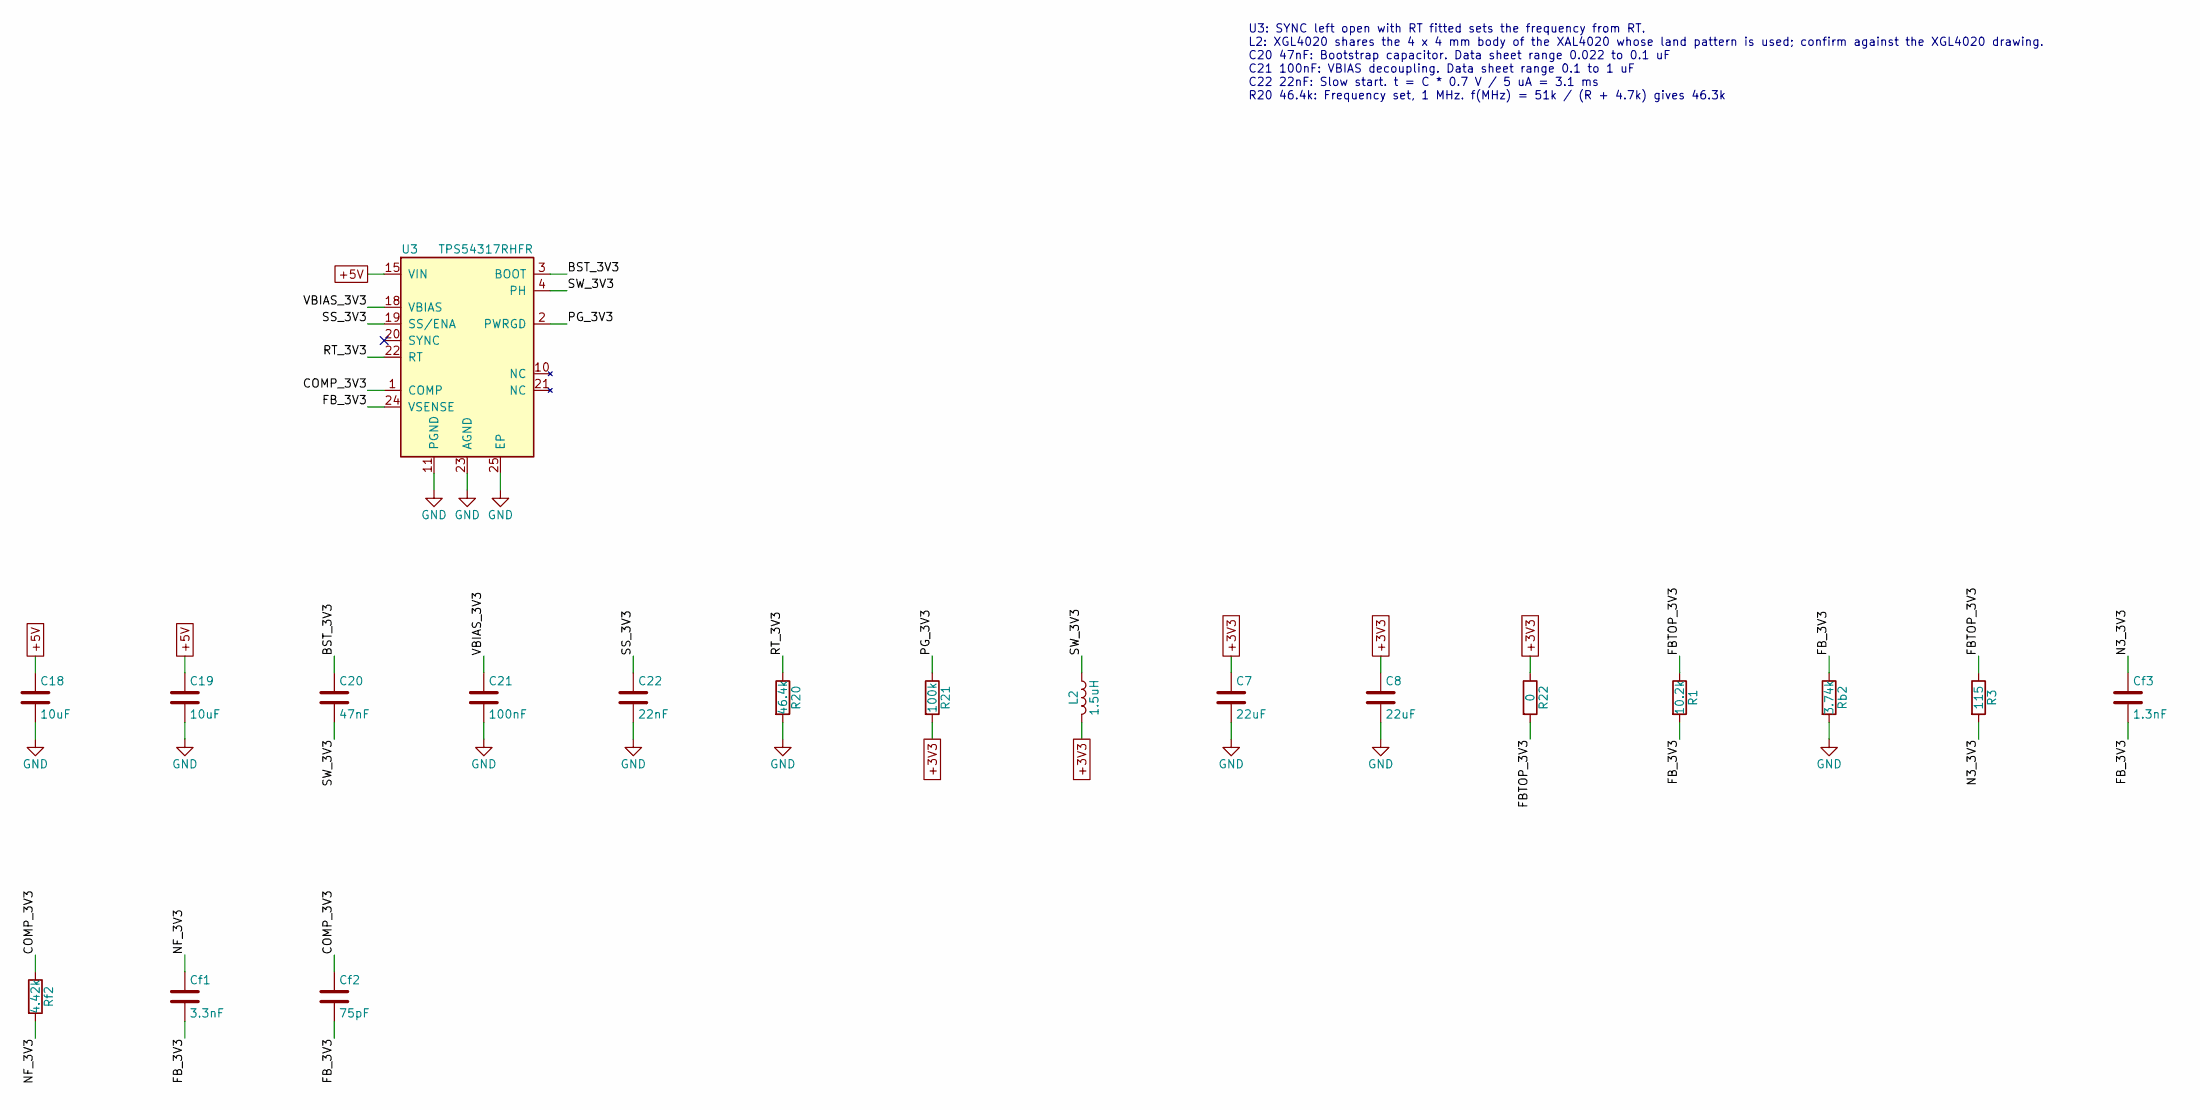
[picture p21: schematic buck_3v3.kicad_sch, +3V3 voltage mode buck]

Parts:
C7, C8: 22uF; C_1206_3216Metric; MPN GRM31CZ71C226ME15L
C18, C19: 10uF; C_0805_2012Metric; MPN CL21B106KOQNNNE
C20: 47nF; C_0402_1005Metric; MPN GRM155R71C473KA01D
C21: 100nF; C_0402_1005Metric; MPN GRM155R71H104KE14D
C22: 22nF; C_0402_1005Metric; MPN GRM155R71H223KA12D
Cf1: 3.3nF; C_0402_1005Metric; MPN GRM1555C1H332JE01D
Cf2: 75pF; C_0402_1005Metric; MPN C0402C750J5GACTU
Cf3: 1.3nF; C_0402_1005Metric; MPN C0402C132J5GACTU
L2: 1.5uH; L_Coilcraft_XAL4020-XXX; MPN XGL4020-152MEC
R1: 10.2k; R_0402_1005Metric; MPN RC0402FR-0710K2L
R3: 115; R_0402_1005Metric; MPN RC0402FR-07115RL
R20: 46.4k; R_0402_1005Metric; MPN RC0402FR-0746K4L
R21: 100k; R_0402_1005Metric; MPN RC0402FR-07100KL
R22: 0; R_0603_1608Metric; MPN RC0603JR-070RL
Rb2: 3.74k; R_0402_1005Metric; MPN RC0402FR-073K74L
Rf2: 4.42k; R_0402_1005Metric; MPN RC0402FR-074K42L
U3: TPS54317RHFR; QFN-24-1EP_4x5mm_P0.5mm_EP2.65x3.65mm; MPN TPS54317RHFR

Connections:
+3V3: C7.1, C8.1, L2.2, R21.2, R22.1; also elsewhere on the board
+5V: C18.1, C19.1, U3.15 (VIN), U3.16 (VIN), U3.17 (VIN); also elsewhere on the board
/buck_3v3/BST_3V3: C20.1, U3.3 (BOOT)
/buck_3v3/COMP_3V3: Cf2.1, Rf2.1, U3.1 (COMP)
/buck_3v3/FBTOP_3V3: R1.1, R3.1, R22.2
/buck_3v3/FB_3V3: Cf1.2, Cf2.2, Cf3.2, R1.2, Rb2.1, U3.24 (VSENSE)
/buck_3v3/N3_3V3: Cf3.1, R3.2
/buck_3v3/NF_3V3: Cf1.1, Rf2.2
/buck_3v3/PG_3V3: R21.1, U3.2 (PWRGD)
/buck_3v3/RT_3V3: R20.1, U3.22 (RT)
/buck_3v3/SS_3V3: C22.1, U3.19 (SS/ENA)
/buck_3v3/SW_3V3: C20.2, L2.1, U3.4 (PH), U3.5 (PH), U3.6 (PH), U3.7 (PH), U3.8 (PH), U3.9 (PH)
/buck_3v3/VBIAS_3V3: C21.1, U3.18 (VBIAS)
GND: C7.2, C8.2, C18.2, C19.2, C21.2, C22.2, R20.2, Rb2.2, U3.11 (PGND), U3.12 (PGND), U3.13 (PGND), U3.14 (PGND), U3.23 (AGND), U3.25 (EP); also elsewhere on the board

Notes on the sheet:
U3: SYNC left open with RT fitted sets the frequency from RT. L2: XGL4020 shares the 4 x 4 mm body of the XAL4020 whose land pattern is used; confirm against the XGL4020 drawing. C20 47nF: Bootstrap capacitor. Data sheet range 0.022 to 0.1 uF C21 100nF: VBIAS decoupling. Data sheet range 0.1 to 1 u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

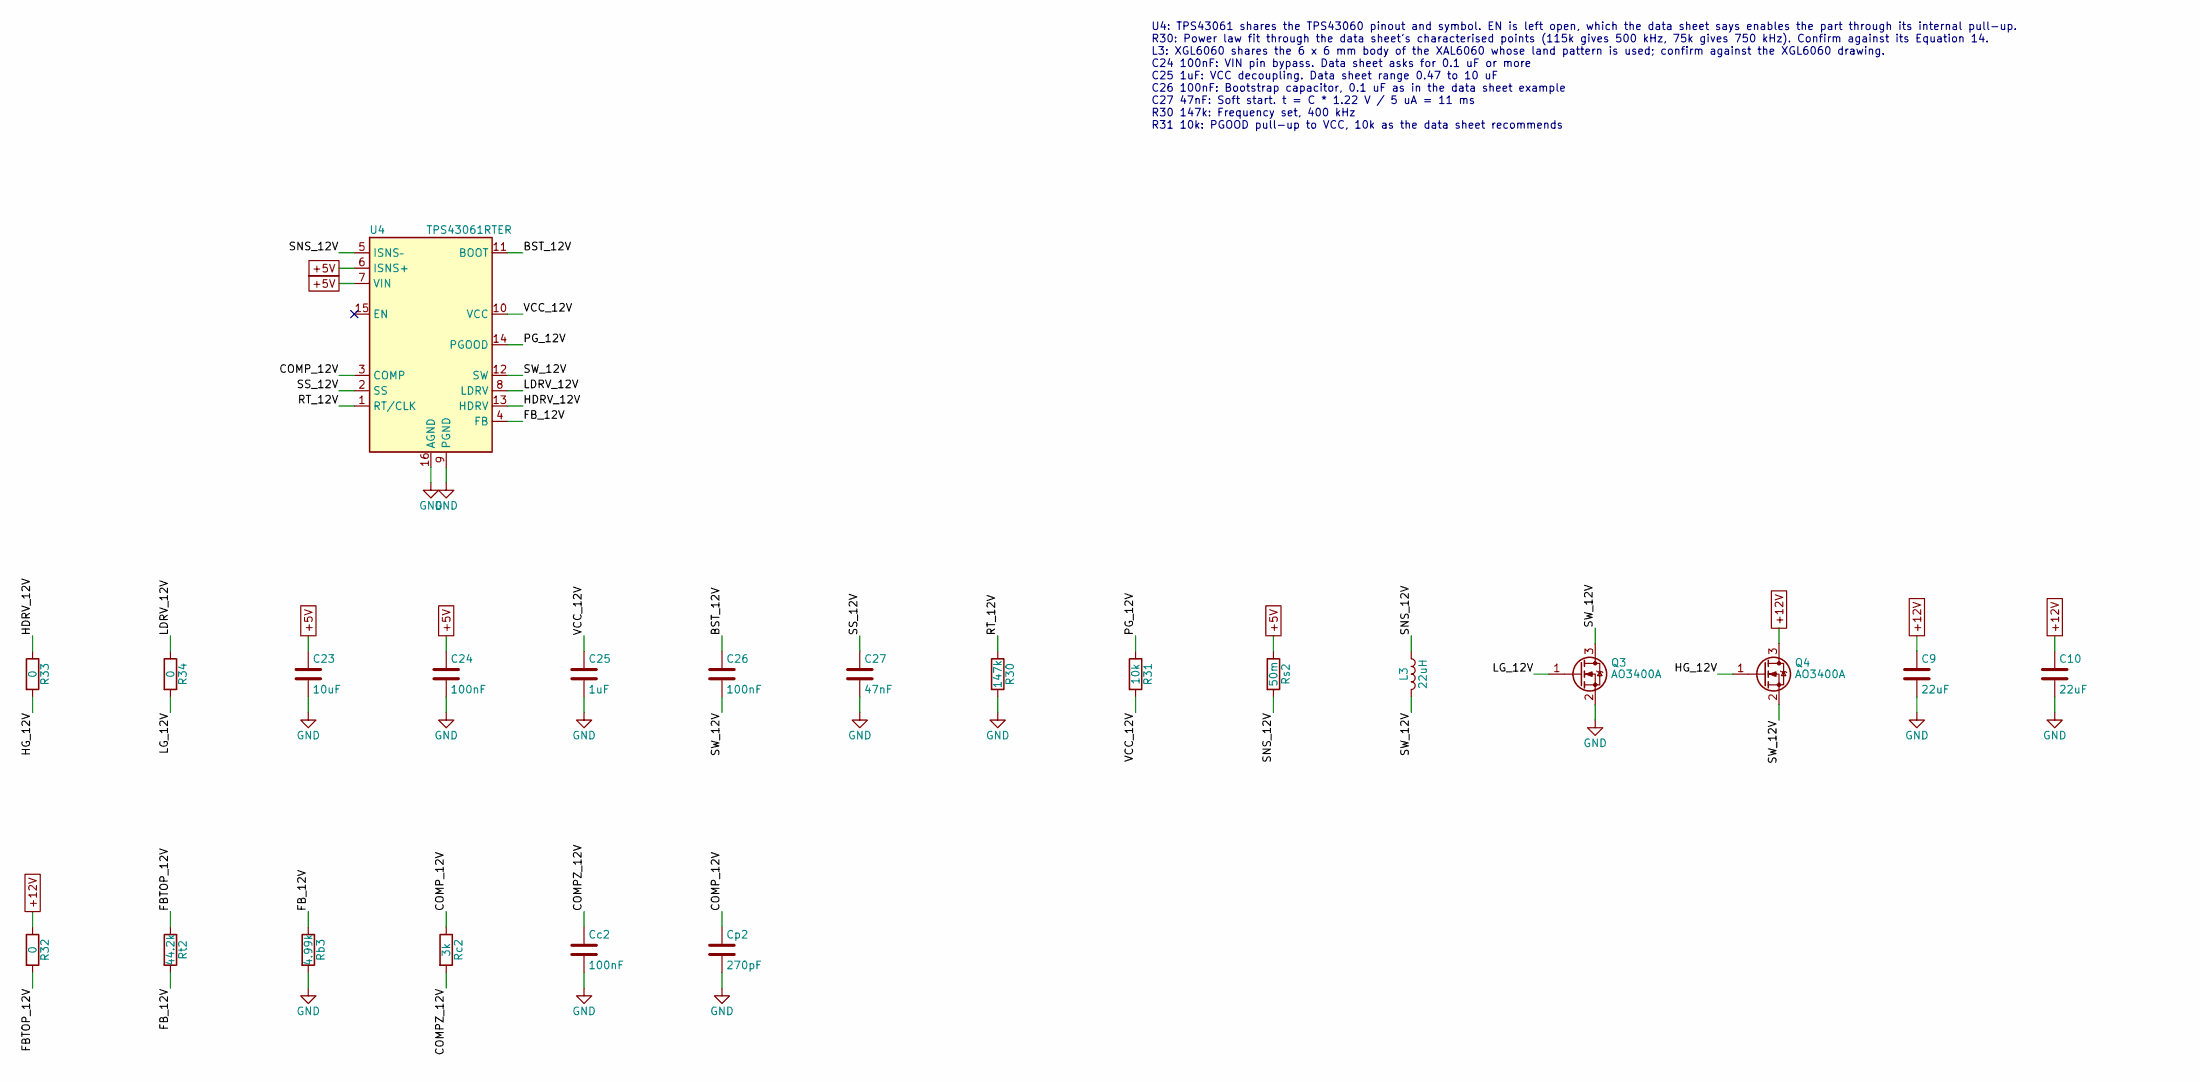
[picture p22: schematic boost_12v.kicad_sch, +12V synchronous boost]

Parts:
C9, C10: 22uF; C_1210_3225Metric; MPN GRM32ER71E226KE15L
C23: 10uF; C_0805_2012Metric; MPN CL21B106KOQNNNE
C24: 100nF; C_0402_1005Metric; MPN GRM155R71H104KE14D
C25: 1uF; C_0603_1608Metric; MPN GRM188R71C105KA12D
C26: 100nF; C_0603_1608Metric; MPN GRM188R71H104KA93D
C27: 47nF; C_0402_1005Metric; MPN GRM155R71C473KA01D
Cc2: 100nF; C_0402_1005Metric; MPN GRM155R71H104KE14D
Cp2: 270pF; C_0402_1005Metric; MPN C0402C271J5GACTU
L3: 22uH; L_Coilcraft_XAL6060-XXX; MPN XGL6060-223MEC
Q3, Q4: AO3400A; SOT-23; MPN AO3400A
R30: 147k; R_0402_1005Metric; MPN RC0402FR-07147KL
R31: 10k; R_0402_1005Metric; MPN RC0402FR-0710KL
R32: 0; R_0603_1608Metric; MPN RC0603JR-070RL
R33, R34: 0; R_0402_1005Metric; MPN RC0402JR-070RL
Rb3: 4.99k; R_0402_1005Metric; MPN RC0402FR-074K99L
Rc2: 3k; R_0402_1005Metric; MPN RC0402FR-073KL
Rs2: 50m; R_0805_2012Metric; MPN WSLP0805R0500FEA
Rt2: 44.2k; R_0402_1005Metric; MPN RC0402FR-0744K2L
U4: TPS43061RTER; Texas_RTE_WQFN-16-1EP_3x3mm_P0.5mm_EP1.2x0.8mm; MPN TPS43061RTER

Connections:
+5V: C23.1, C24.1, Rs2.1, U4.6 (ISNS+), U4.7 (VIN); also elsewhere on the board
+12V: C9.1, C10.1, Q4.3 (D), R32.1; also elsewhere on the board
/boost_12v/BST_12V: C26.1, U4.11 (BOOT)
/boost_12v/COMPZ_12V: Cc2.1, Rc2.2
/boost_12v/COMP_12V: Cp2.1, Rc2.1, U4.3 (COMP)
/boost_12v/FBTOP_12V: R32.2, Rt2.1
/boost_12v/FB_12V: Rb3.1, Rt2.2, U4.4 (FB)
/boost_12v/HDRV_12V: R33.1, U4.13 (HDRV)
/boost_12v/HG_12V: Q4.1 (G), R33.2
/boost_12v/LDRV_12V: R34.1, U4.8 (LDRV)
/boost_12v/LG_12V: Q3.1 (G), R34.2
/boost_12v/PG_12V: R31.1, U4.14 (PGOOD)
/boost_12v/RT_12V: R30.1, U4.1 (RT/CLK)
/boost_12v/SNS_12V: L3.1, Rs2.2, U4.5 (ISNS–)
/boost_12v/SS_12V: C27.1, U4.2 (SS)
/boost_12v/SW_12V: C26.2, L3.2, Q3.3 (D), Q4.2 (S), U4.12 (SW)
/boost_12v/VCC_12V: C25.1, R31.2, U4.10 (VCC)
GND: C9.2, C10.2, C23.2, C24.2, C25.2, C27.2, Cc2.2, Cp2.2, Q3.2 (S), R30.2, Rb3.2, U4.9 (PGND), U4.16 (AGND), U4.17 (AGND); also elsewhere on the board

Notes on the sheet:
U4: TPS43061 shares the TPS43060 pinout and symbol. EN is left open, which the data sheet says enables the part through its internal pull-up. R30: Power law fit through the data sheet's characterised points (115k gives 500 kHz, 75k gives 750 kHz). Confirm against its Equation 14. L3: XGL6060 shares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

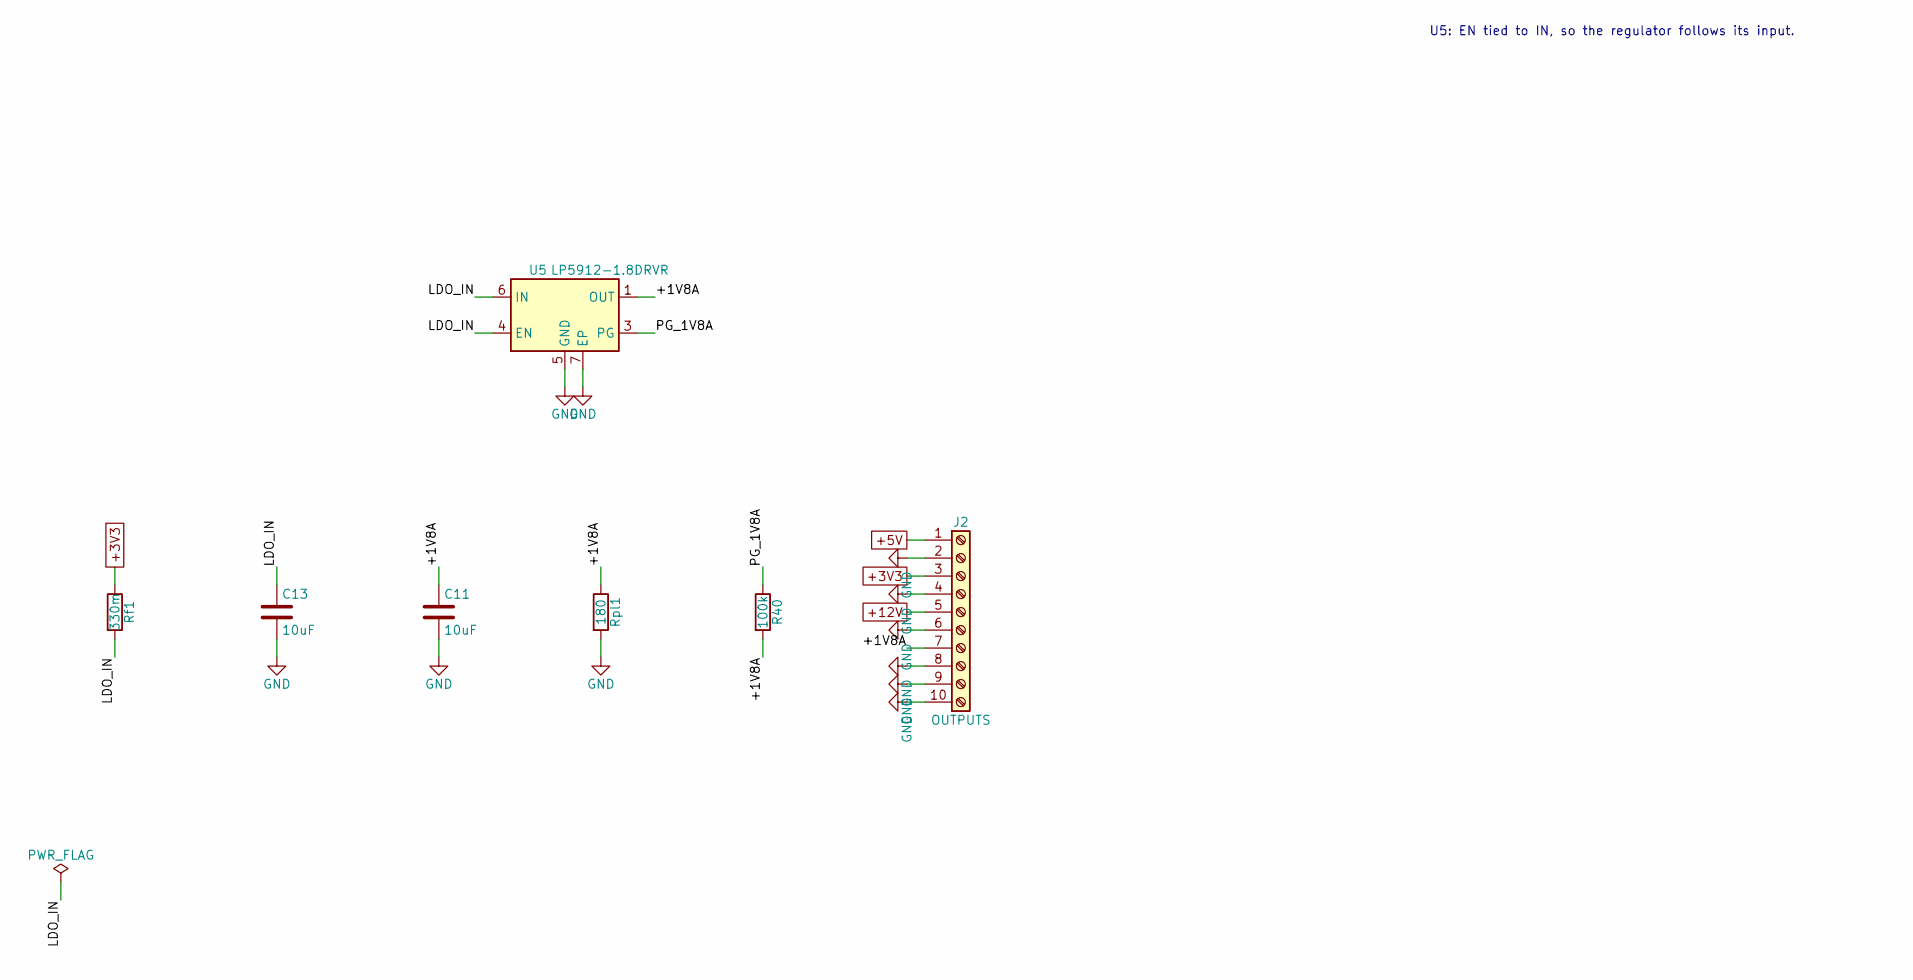
[picture p23: schematic ldo_outputs.kicad_sch, +1V8A low noise LDO and output connector]

Parts:
C11: 10uF; C_0805_2012Metric; MPN GRM21BR70J106KE76L
C13: 10uF; C_0805_2012Metric; MPN CL21B106KOQNNNE
J2: OUTPUTS; TerminalBlock_Phoenix_MKDS-1,5-10-5.08_1x10_P5.08mm_Horizon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; MPN 1715802
R40: 100k; R_0402_1005Metric; MPN RC0402FR-07100KL
Rf1: 330m; R_0805_2012Metric; MPN RL0805FR-7W0R33L
Rpl1: 180; R_0603_1608Metric; MPN RC0603FR-07180RL
U5: LP5912-1.8DRVR; WSON-6-1EP_2x2mm_P0.65mm_EP1x1.6mm; MPN LP5912-1.8DRVR

Connections:
+3V3: J2.3, Rf1.1; also elsewhere on the board
+5V: J2.1; also elsewhere on the board
+12V: J2.5; also elsewhere on the board
/ldo_outputs/+1V8A: C11.1, J2.7, R40.2, Rpl1.1, U5.1 (OUT)
/ldo_outputs/LDO_IN: C13.1, Rf1.2, U5.4 (EN), U5.6 (IN)
/ldo_outputs/PG_1V8A: R40.1, U5.3 (PG)
GND: C11.2, C13.2, J2.2, J2.4, J2.6, J2.8, J2.9, J2.10, Rpl1.2, U5.5 (GND), U5.7 (EP); also elsewhere on the board

Notes on the sheet:
U5: EN tied to IN, so the regulator follows its input.

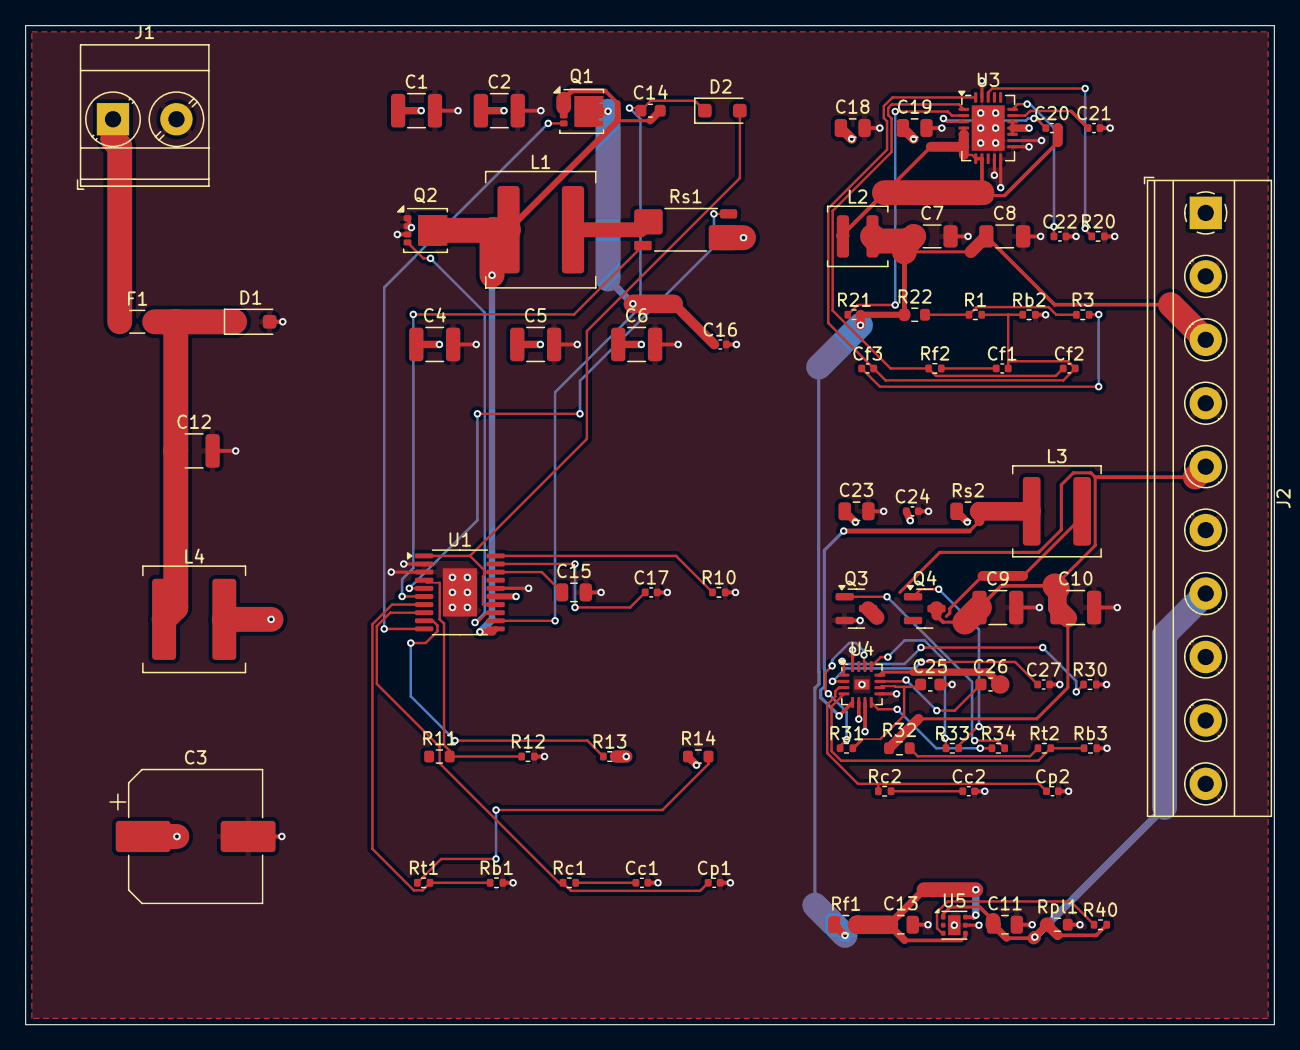
[picture p24: board emb-multirail-smps.kicad_pcb from above]

Board: 4 copper layers, 100.0 x 80.0 mm, 79 parts (0 on the bottom side), 52 nets.
