CGainsWorks/emb-multirail-smps/(commit log)

2026-08-22 Design and validate the multi-rail supply in simulation
    Four rails from an 8 to 36 V input: a synchronous buck, a second buck
    cascaded from it, a synchronous boost and a low noise LDO, delivering
    21.4 W at the connectors.
    The point of the repository is the loop validation. Each loop is derived
    by hand from state space averaging, with the peak current mode loops
    closed using the Ridley sampled data model, and then measured off a
    cycle accurate switching simulation of the same converter using the
    injection method a Bode analyser uses. The two routes share the
    component values and nothing else. They agree to within 5.8 percent on
    crossover and 4.0 degrees on phase margin, which is the gate the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
    [VERIFY.csv, ambient_derating.csv, bom.csv, compensation_values.csv, curve_12v.csv, curve_1v8a.csv, curve_3v3.csv, curve_5v.csv]
2026-08-22 Add directory level notes, map the brief's checklist, use ubuntu-latest
    The pinned ubuntu-22.04 runner label no longer resolves, so every job
    failed before running a step. ubuntu-latest is the label that stays
    valid.
    Also adds outputs/README.md and test-results/README.md so that somebody
    browsing either directory sees immediately what is generated and, in the
    case of test-results, that none of it was measured. STATUS.md now maps
    the project brief's fourteen milestones onto what is actually done.
2026-08-22 Move the headline check into a script CI and a human can both run
    The check was an indented heredoc inside the workflow, which bash would
    never have terminated: <<'PY' requires the closing marker at column
    zero. It is now scripts/check_headline.py, wired to 'make headline',
    which also means the guard on the README's numbers can be run locally
    before pushing rather than only discovered in CI.
2026-10-15 Rebuild the workflow to spend as few Actions minutes as possible
    One job instead of four, so the checkout and the dependency install are
    paid for once and shared by the tests, the regeneration and the headline
    guard. Path filters so a documentation only commit does not start a
    runner. Concurrency so pushing twice cancels the first run instead of
    paying for both. A pip cache, and timeout-minutes so a hung job cannot
    quietly consume the month's allowance. The Python version matrix moves
    to manual dispatch, because what it catches is library behaviour across
    versions and that does not change when this repository changes.
    Roughly 3 to 4 minutes per push against about 12 for the obvious
    arrangem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
2026-10-15 Compare regenerated outputs as numbers, not as bytes
    The first run on a real runner failed the staleness check, and the
    reason was worth chasing rather than suppressing. The settled output
    voltages differed in the sixth decimal place between this machine and
    the runner, about one part per million. That is not line endings and it
    is not an accumulation of rounding: the switching simulator locates each
    switching instant by secant iteration, where it stops depends on the
    last bits of a double precision subtraction, and the closed loop then
    integrates those duty ratio differences over thousands of cycles. Two
    numpy builds on two operating systems do not agree at that level and
    never will.
    One p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
2026-10-15 Judge near-zero derived columns on an absolute floor
    The first run with the numeric comparison still failed, and on exactly
    the column the report had already warned about. The load and line
    regulation deviations are differences of two nearly equal voltages: they
    sit around 0.001 percent, and between platforms their relative spread
    reaches 100 percent while their absolute spread is a few parts per
    million of a volt. Relative tolerance alone was always going to fail
    there.
    Two changes, both of which stand on their own.
    The comparison now uses the usual combined rule, |a-b| <= atol + rtol|b|,
    with the floor at 5e-4 of a reported unit. That is a statement about what
    this repository claims: not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
    [line_regulation.csv, load_regulation.csv]
2026-10-15 Record that all three Python versions now pass
    The manual dispatch was run to prove the matrix path works rather than
    leaving it as untested configuration: 3.9, 3.11 and 3.12 all pass, 101
    seconds of wall clock for the three jobs together, zero billable
    milliseconds. STATUS.md said 3.11 had never been run anywhere, which is
    no longer true.
    Also states in STATUS.md why the outputs check compares numbers rather
    than bytes, since that was forced by a real cross platform failure
    rather than chosen for convenience.
2026-10-15 Run the decks in ngspice, and stop claiming they are portable
    The repository emitted SPICE decks and said they run in LTspice and in
    ngspice. Nothing had ever executed one, and the claim was false:
    Rser= on a reactive component, IF(a,b,c) and LIMIT(x,lo,hi) are LTspice
    extensions that ngspice rejects outright. Asserting something no tool
    had checked is the failure this repository is otherwise built to avoid.
    So the decks are now emitted in two dialects that are genuinely
    different, and the ngspice ones are executed by CI on every push.
    scripts/run_ngspice.py runs each deck in batch mode and compares the
    result against the Python models: the compensator networks to 0.05 dB
    and 0.5 degrees, t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
    [line_regulation.csv, load_regulation.csv]
2026-10-15 Make the switching deck converge in ngspice
    The AC decks passed first time and agree with the closed forms to
    0.0001 dB and 0.11 degrees, which is the result this was for. The
    switching deck did not converge: ideal switches driven by an infinitely
    sharp comparator is the classic way to make a general purpose solver
    give up, and it gave up mid switching edge with the output already at
    the right 3.319 V.
    Three changes, none of which alters the circuit in any way that matters
    at 1 MHz. The comparator gets a finite transition region, about 0.5 mV
    wide, which is under a nanosecond of ramp. The switch model gets
    hysteresis so it cannot chatter across its threshold. Integration moves
    to Gear, whic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
2026-10-15 Remove the dead time artefact from the ngspice switching deck
    ngspice converged and settled at 3.3184 V against the divider's
    3.3185 V, which is the agreement worth having. Its ripple read 6.38
    mVpp against 2.74 mVpp from the simulator in this repository, and 2.3
    times is not a difference to publish without explaining.
    The cause was the hysteresis added to cure the convergence. It opens a
    window where neither switch conducts, and with no body diodes in the
    deck the inductor current then drives the switch node through a megohm
    and rings. That is a modelling artefact, not a property of the
    converter. The hysteresis is gone; the finite comparator transition is
    what was actually fixing the conv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
2026-10-15 Bound the comparator so Newton cannot run away
    The tanh comparator converged nowhere: it saturates, so its derivative
    vanishes, and with no gradient to follow the solver drove the gate node
    to a thousand volts. A comparator that is linear across a 1 mV band and
    hard limited outside it keeps the Jacobian finite where it matters and
    keeps the output inside [0, 1] however badly an iteration misbehaves.
    The hysteresis is back. The previous commit removed it and changed the
    time step in the same breath, which was careless: the two effects could
    not then be told apart, and the dead time explanation for the ripple it
    offered was a hypothesis stated as a finding. The configuration that is
    known to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
2026-10-15 Report what ngspice actually agrees to, and tighten the tolerance to it
    The run that converged gives the answer, and it corrects the guess two
    commits ago. Removing the hysteresis was not what fixed the ripple: with
    the hysteresis still in place, halving the time step took it from 6.4
    mVpp to 3.9 mVpp against 2.7 mVpp here. The first figure was mostly
    discretisation rather than circuit behaviour, and publishing it with an
    invented explanation would have been easy and wrong. The deck now says
    so, because the next person to change the time step should know what it
    moves.
    Measured agreement on the AC decks, which is what this was for: worst
    gain error 0.0001 dB and worst phase error 0.110 degr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
2026-10-16 Select real parts and take the controller figures from their data sheets
    Every BOM line now names a real part: LTC3891 for the +5V buck, TPS54317 for
    the +3V3 buck, TPS43061 for the +12V boost and LP5912-1.8 for the LDO, with
    real inductors, shunts, capacitors, FETs, fuse, TVS and terminals.
    The reference voltage, error amplifier transconductance, gain and bandwidth
    of each controller are read from its data sheet and used by the model, so the
    dividers and compensation networks were re-derived: the +3V3 and +12V
    references are 0.891 V and 1.22 V, not the 0.8 V assumed before. Everything
    else that is still an assumption is listed against the data sheet figure in
    outputs/VERIFY.csv.
    The switc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
    [VERIFY.csv, bom.csv, compensation_values.csv, line_regulation.csv, load_regulation.csv, load_step.csv, loop_margins.csv, sweep_12v.csv]
2026-10-16 Interpolate the settling time, and update the bring-up figures
    The settling time was the last waveform sample outside the band, so it moved
    by a sample spacing between Windows and Linux whenever a sample landed the
    other side of the crossing. It is now interpolated between that sample and
    the next one.
    The bring-up procedure quotes the new set points, ripple and transients.
    [VERIFY.csv, load_step.csv]
2026-10-16 Quote settling time to a tenth of a microsecond
    Even interpolated, the moment a rippling waveform last leaves its band moves
    by about 0.01 us between platforms. A second decimal was quoting that.
    [load_step.csv]
2026-10-16 Take the ngspice set point from the regulator's reference
    run_ngspice.py hard coded the 0.8 V that the +3V3 rail assumed before a part
    was chosen. The README quotes what ngspice now reports.
2026-10-16 Capture the schematic in KiCad and hold it to the simulation in CI
    A KiCad 8 project in hardware/kicad: a root sheet and one sheet per stage,
    79 parts with real part numbers and footprints, generated from
    simulation/smps/hardware.py so every modelled value is the one the
    simulation uses. Two controller symbols KiCad does not ship are drawn from
    their data sheet pin tables.
    CI runs kicad-cli in the pinned kicad/kicad:8.0.9 image: ERC with every
    severity enabled has to report nothing, then the exported netlist is checked
    by scripts/kicad/check_netlist.py against every R, L and C in the ngspice
    decks (value after DC bias derating, and the nets each part joins), against
    the inductors, shunts an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
    [boost_12v.kicad_sch, buck_3v3.kicad_sch, emb-multirail-smps.kicad_sch, input_5v.kicad_sch, ldo_outputs.kicad_sch]
2026-10-16 Lay out the four layer board and run DRC on it in CI
    hardware/kicad/emb-multirail-smps.kicad_pcb is 100 by 80 mm on the
    docs/stackup.md stackup: 2/1/1/2 oz, 0.2 mm prepreg under each outer layer
    and a 1.065 mm core, ground plane on In1 and VIN, +5V and +3V3 pours on In2.
    Parts are placed by stage region by scripts/kicad/gen_pcb.py, every plane net
    pad gets a via to its plane, 0.30 mm thermal vias go under the exposed pads,
    and Freerouting 2.4.1 routes the rest, with power tracks widened afterwards
    as far as clearance allows.
    CI runs DRC with schematic parity on the committed board. Every check passes
    except five connections the autorouter did not complete, three at the +12V
    boost's synchron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
    [emb-multirail-smps.kicad_pcb]
2026-10-16 Say what exists now: parts, KiCad schematic, a board with five open connections
    STATUS.md is dated 2026-10-16 and records the part selection, the KiCad
    schematic and its checks, the board and its five unrouted connections, the
    layout review that has not been done, where the selected parts' data sheets
    and the model still disagree, and a hardware TODO for the bench efficiency,
    Bode and EMC pre-scan measurements the simulation stands in for. The README,
    the Altium pointer, the outputs notes and the stackup's power gap follow.
